icl-rocketry/iclr-hw/3d/SON127P600X800X65-8N.STEP

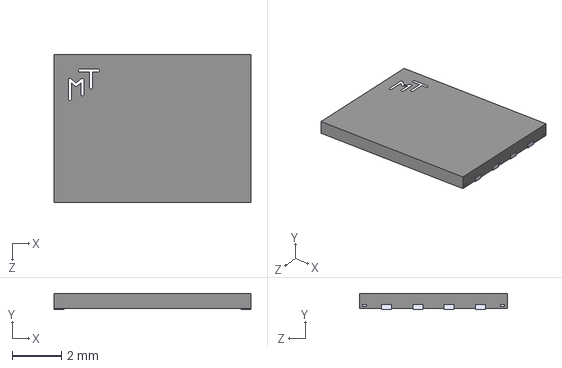
[picture p1: CAD file, 2025-12-16]
3d/SON127P600X800X65-8N.STEP
8.00 x 0.65 x 6.00 mm
