icl-rocketry/iclr-hw/3d/Pico-Clasp_SMD_4p.stp

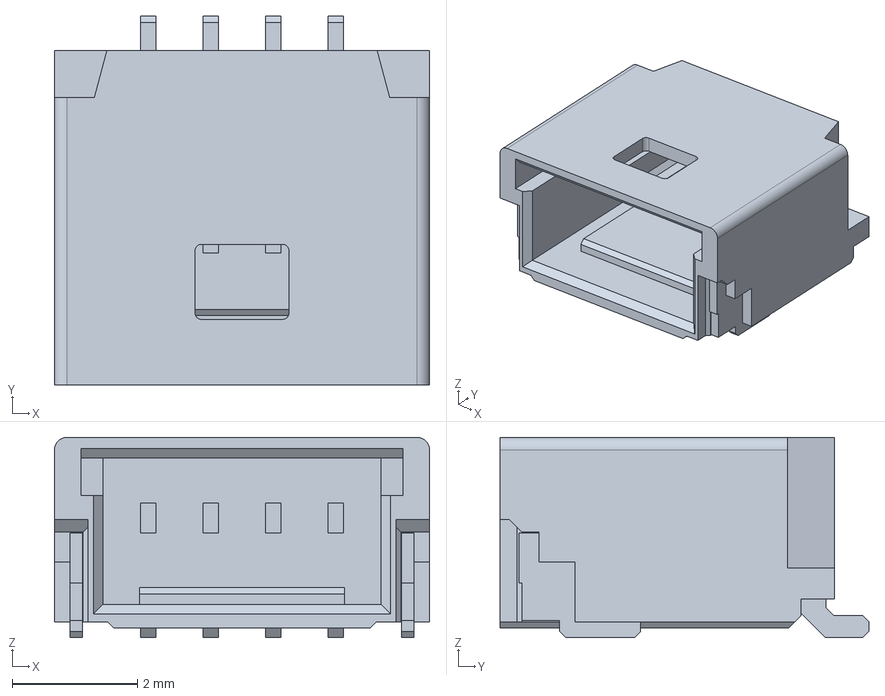
[picture p2: CAD file, 2025-05-08]
3d/Pico-Clasp_SMD_4p.stp
6.00 x 5.90 x 3.20 mm
