icl-rocketry/iclr-hw/3d/TCMT1109.STEP

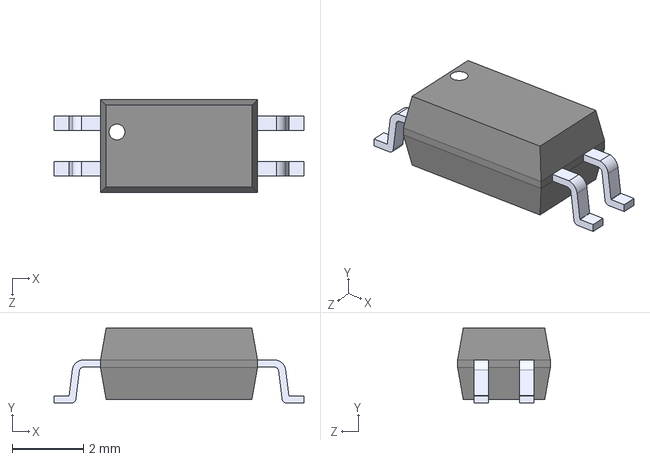
[picture p3: CAD file, 2025-05-08]
3d/TCMT1109.STEP
7.00 x 2.10 x 2.60 mm
