icl-rocketry/iclr-hw/3d/WE-XHMI.stp

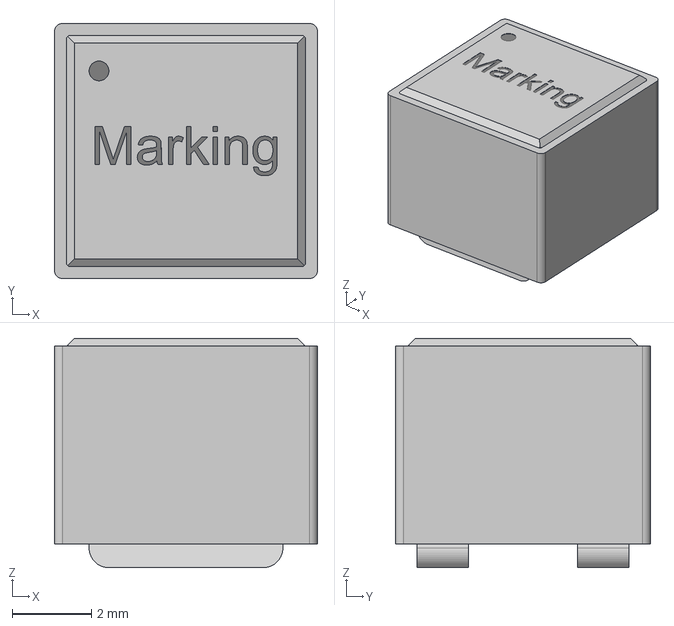
[picture p4: CAD file, 2025-05-08]
3d/WE-XHMI.stp
6.65 x 6.45 x 5.80 mm
