icl-rocketry/iclr-hw/3d/Pico-Clasp_SMD_7p.step

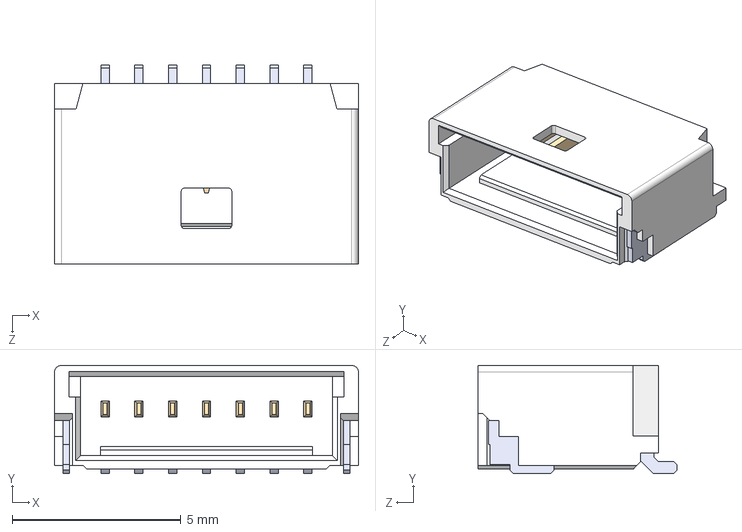
[picture p5: CAD file, 2025-02-14]
3d/Pico-Clasp_SMD_7p.step
9.00 x 3.20 x 5.90 mm
