icl-rocketry/iclr-hw/3d/2pinnanofithorizontal.STEP

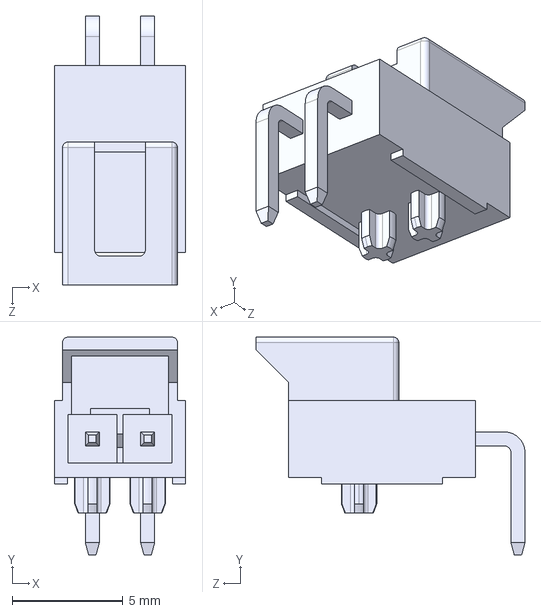
[picture p6: CAD file, 2024-09-12]
3d/2pinnanofithorizontal.STEP
5.94 x 9.84 x 12.2 mm
