icl-rocketry/iclr-hw/3d/SI7635DP-T1-GE3.STEP

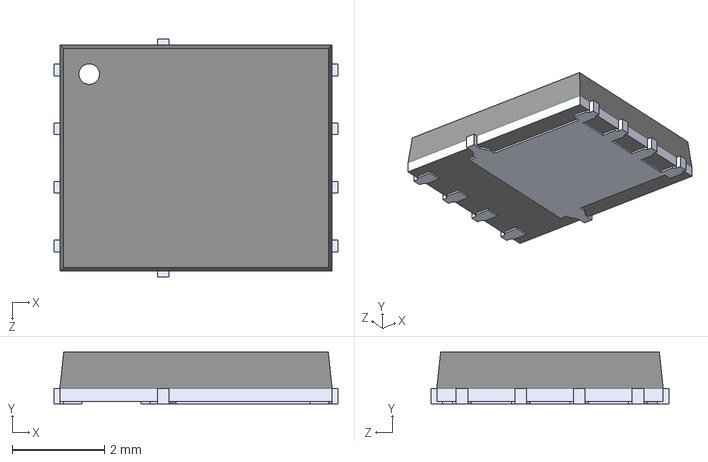
[picture p7: CAD file, 2024-09-12]
3d/SI7635DP-T1-GE3.STEP
6.15 x 1.12 x 5.16 mm
