icl-rocketry/iclr-hw/3d/FDSD0630-H-1R0M_P3.step

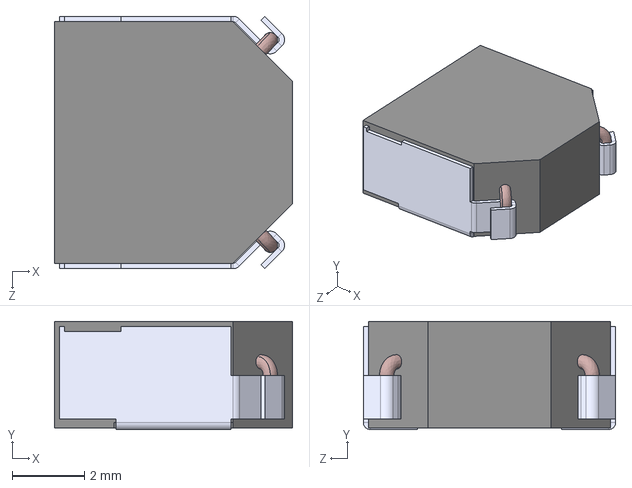
[picture p8: CAD file, 2024-09-10]
3d/FDSD0630-H-1R0M_P3.step
6.60 x 3.00 x 7.00 mm
