icl-rocketry/iclr-hw/3d/ERJ-HP6F7322V.stp

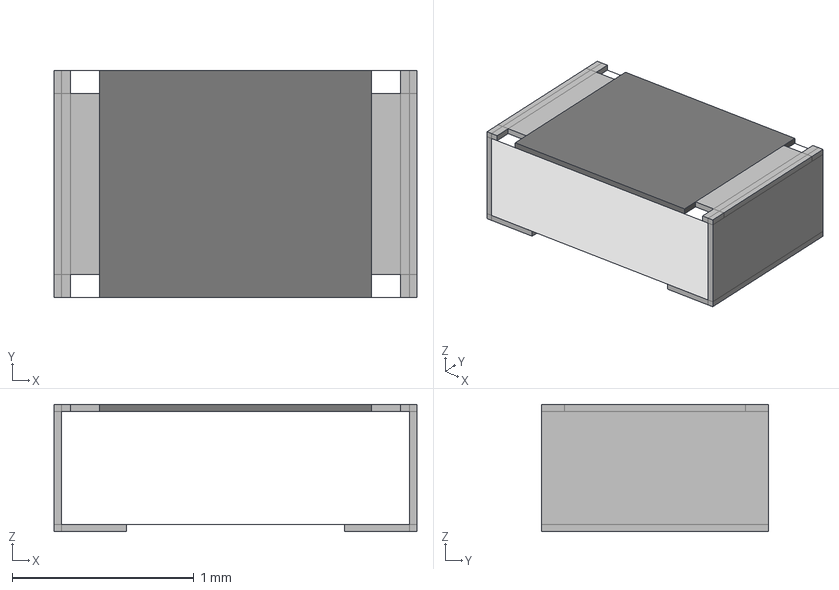
[picture p9: CAD file, 2024-09-10]
3d/ERJ-HP6F7322V.stp
2.00 x 1.25 x 0.7 mm
solidBody
solidLead
solidTop
