icl-rocketry/iclr-hw/3d/VCAS080512A250DP.stp

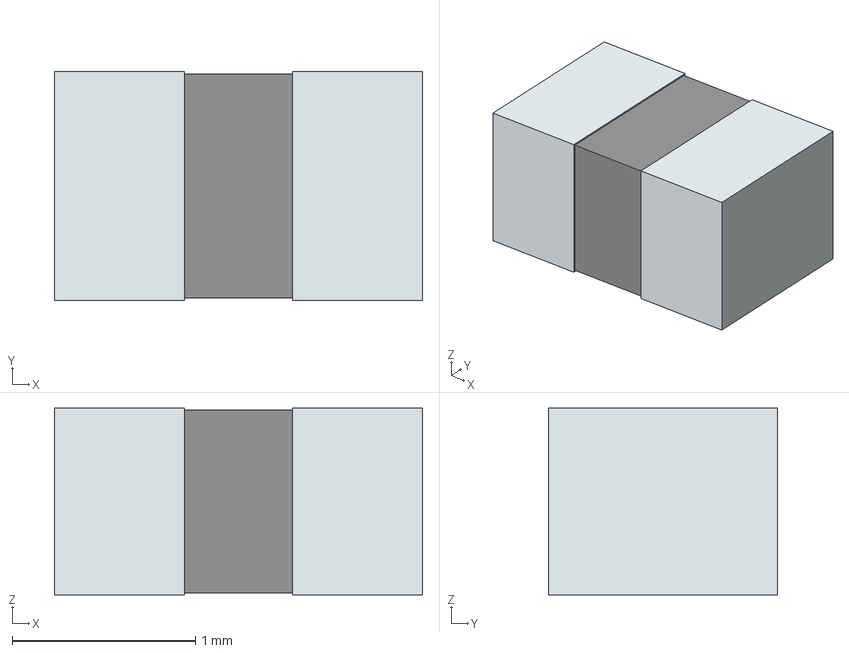
[picture p10: CAD file, 2024-09-10]
3d/VCAS080512A250DP.stp
2.01 x 1.25 x 1.02 mm
term1
term2
