icl-rocketry/iclr-hw/3d/V8PAM10S-M3_I.stp

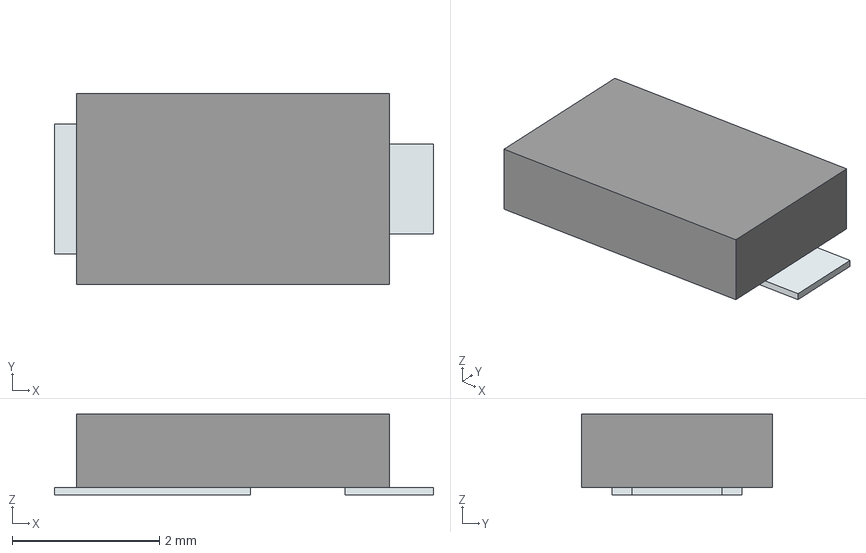
[picture p11: CAD file, 2024-09-09]
3d/V8PAM10S-M3_I.stp
5.15 x 2.60 x 1.10 mm
Pins
