icl-rocketry/iclr-hw/3d/TMC2209-LA.stp

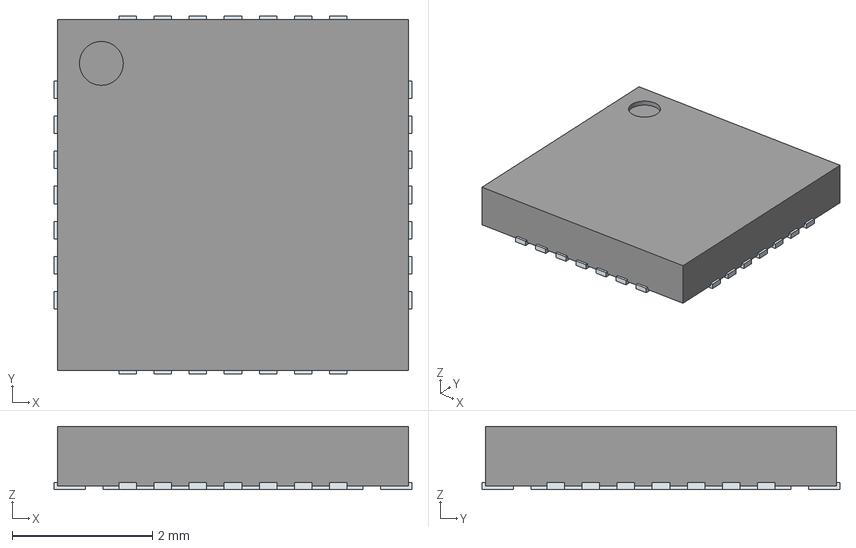
[picture p12: CAD file, 2024-08-27]
3d/TMC2209-LA.stp
5.10 x 5.10 x 0.9 mm
ThermalPin
PinsArrayLR
PinsArrayTB
