icl-rocketry/iclr-hw/3d/MIC5060YML-TR.stp

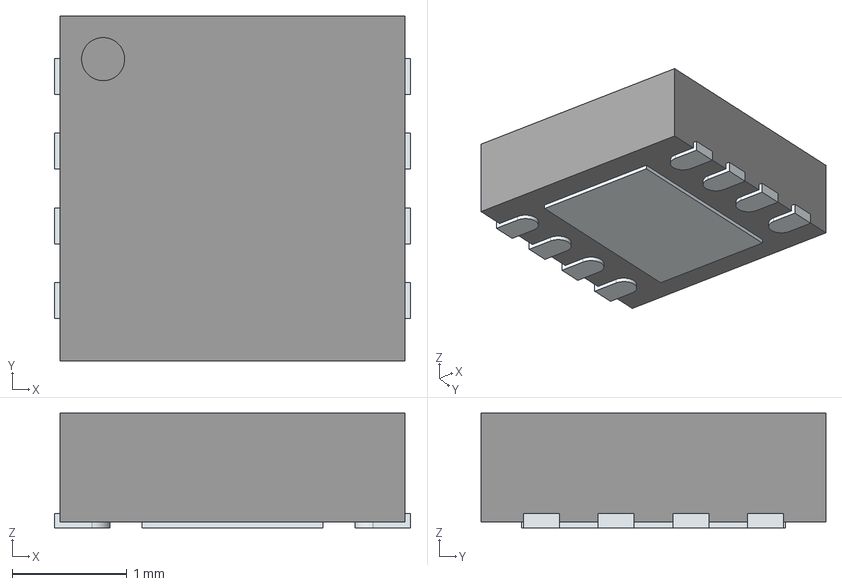
[picture p13: CAD file, 2024-08-24]
3d/MIC5060YML-TR.stp
3.10 x 3.00 x 1.00 mm
ThermalPin
PinsArrayLR
