icl-rocketry/iclr-hw/3d/BSZ025N04LS.stp

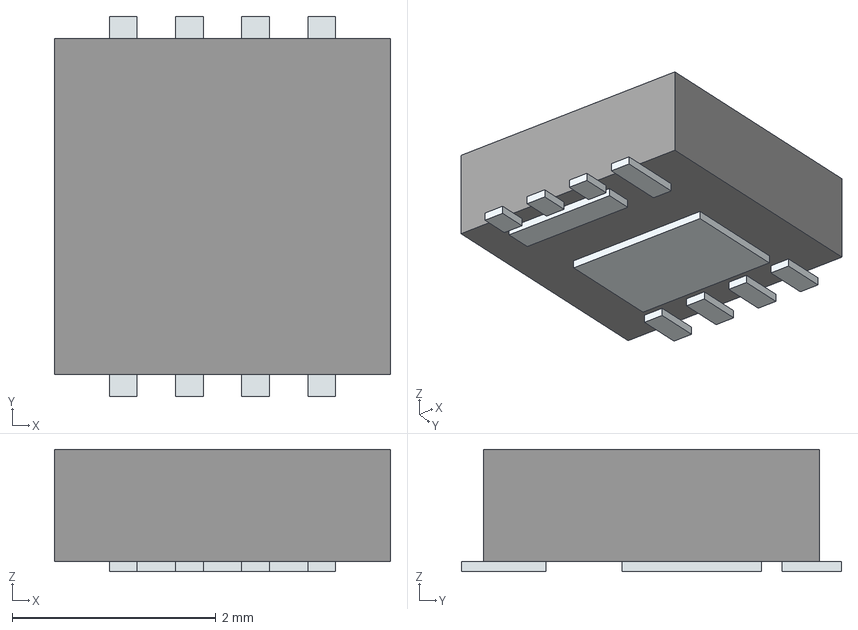
[picture p14: CAD file, 2024-08-22]
3d/BSZ025N04LS.stp
3.30 x 3.73 x 1.20 mm
Pins
