icl-rocketry/iclr-hw/3d/RCLAMP3346PTNT.stp

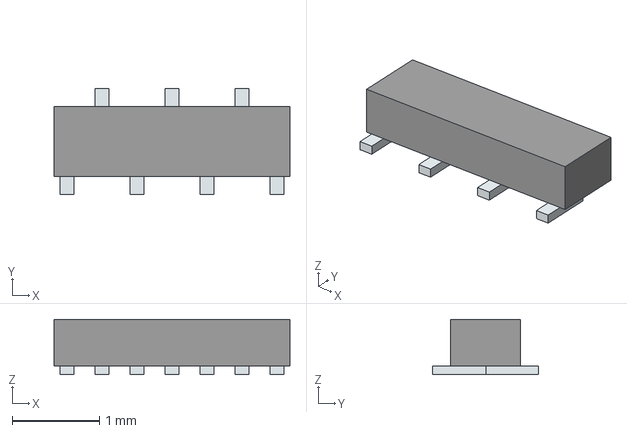
[picture p15: CAD file, 2024-08-18]
3d/RCLAMP3346PTNT.stp
2.70 x 1.21 x 0.63 mm
Pins
