icl-rocketry/iclr-hw/3d/SOT-723.step

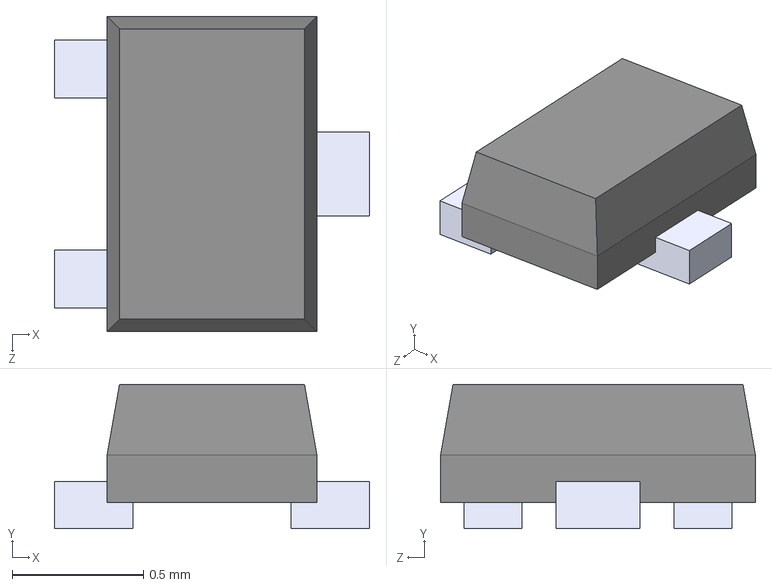
[picture p16: CAD file, 2024-08-14]
3d/SOT-723.step
1.20 x 0.55 x 1.20 mm
