icl-rocketry/iclr-hw/3d/ST1W008S4TR2000.step

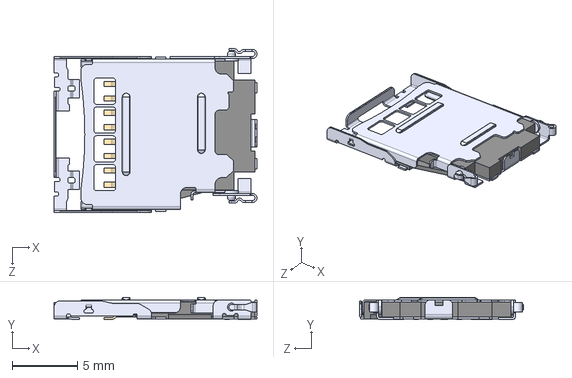
[picture p17: CAD file, 2024-08-09]
3d/ST1W008S4TR2000.step
15.5 x 1.68 x 12.5 mm
