icl-rocketry/iclr-hw/3d/CMT-0525-75-SMT-TR.stp

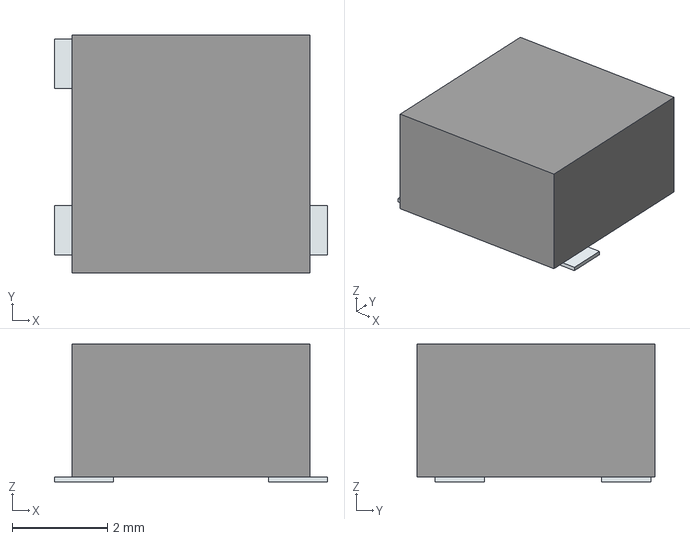
[picture p18: CAD file, 2024-08-07]
3d/CMT-0525-75-SMT-TR.stp
5.74 x 5.00 x 2.90 mm
Pins
