icl-rocketry/iclr-hw/3d/S-102T.stp

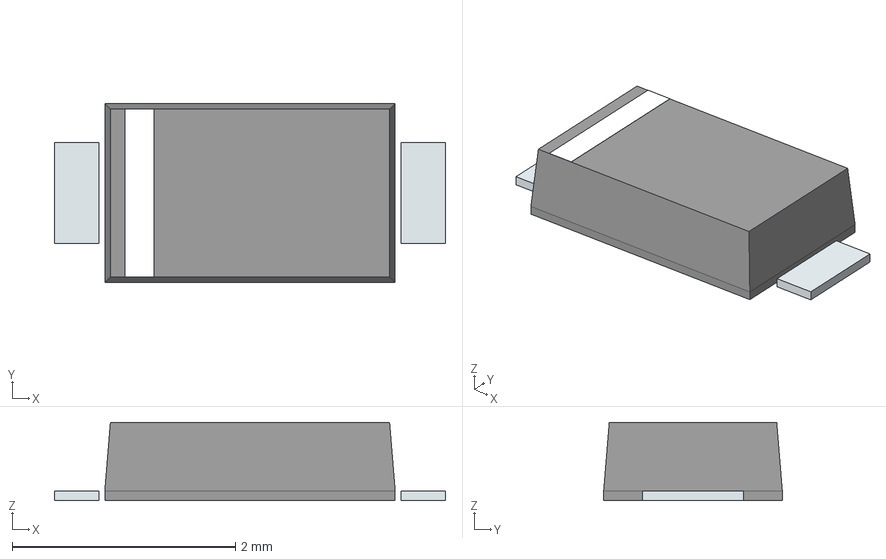
[picture p19: CAD file, 2024-08-04]
3d/S-102T.stp
3.50 x 1.60 x 0.7 mm
PinKIdent
PinK
PinA
