icl-rocketry/iclr-hw/3d/XT30PW-F.stp

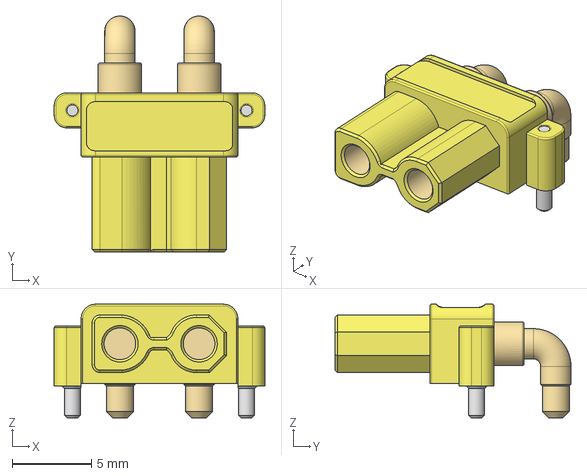
[picture p20: CAD file, 2024-07-31]
3d/XT30PW-F.stp
13.3 x 14.9 x 7.18 mm
