icl-rocketry/iclr-hw/3d/XT30PW-M.stp

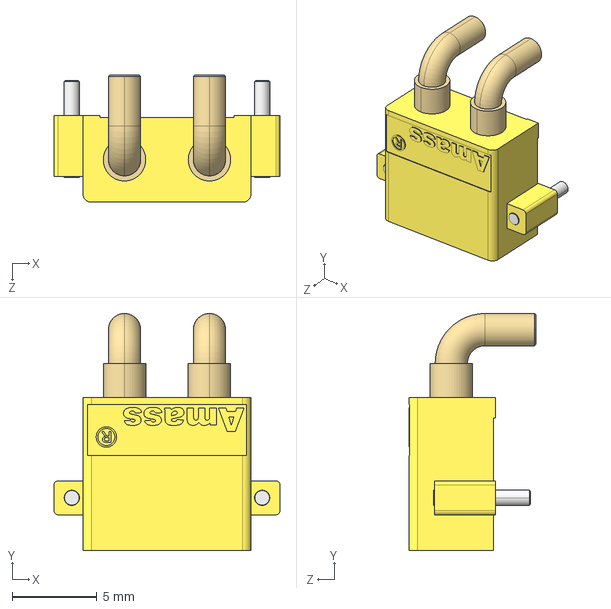
[picture p21: CAD file, 2024-07-31]
3d/XT30PW-M.stp
13.3 x 13.9 x 7.50 mm
