icl-rocketry/iclr-hw/3d/DPS368XTSA1.stp

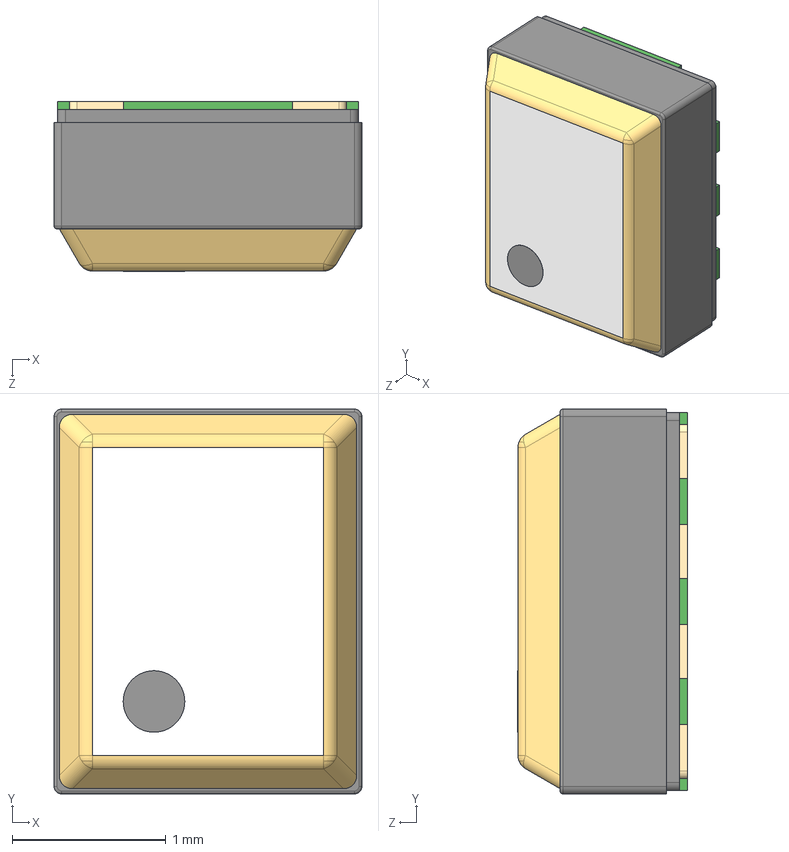
[picture p22: CAD file, 2024-07-11]
3d/DPS368XTSA1.stp
2.00 x 2.50 x 1.10 mm
Notch
Infineon Logo Adjustable_5
