icl-rocketry/iclr-hw/3d/ADS131M04IRUKR.stp

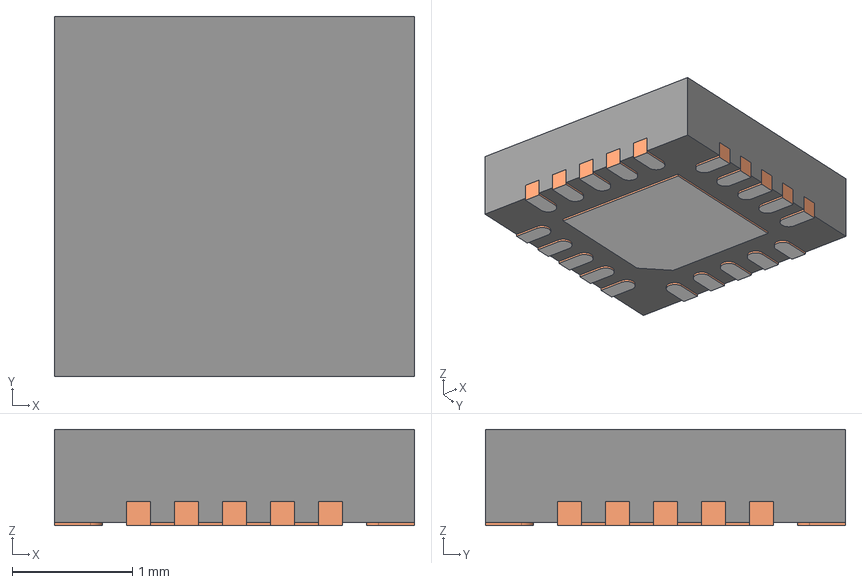
[picture p23: CAD file, 2024-06-09]
3d/ADS131M04IRUKR.stp
3.00 x 3.00 x 0.8 mm
BODY-QFN
FRAME-RUK0020B
PIN1-ID
