icl-rocketry/iclr-hw/3d/NX2016SA.STEP

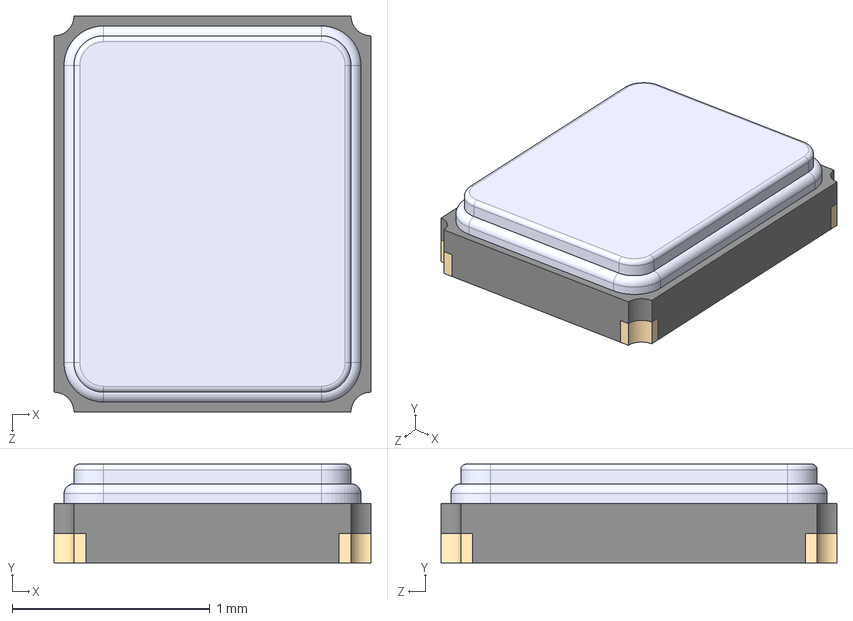
[picture p24: CAD file, 2024-06-09]
3d/NX2016SA.STEP
1.60 x 0.5 x 2.00 mm
