icl-rocketry/iclr-hw/3d/SQS141ELNW-T1_GE3.stp

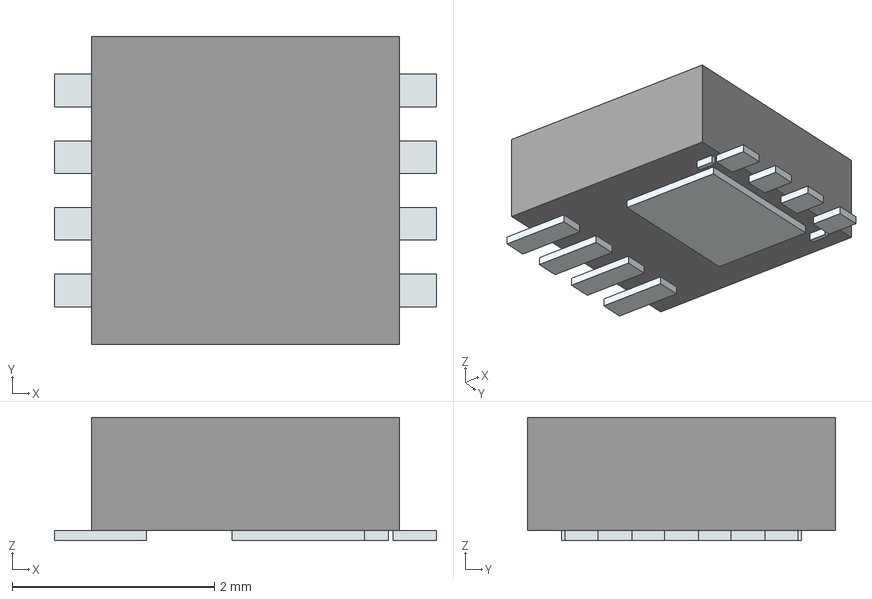
[picture p25: CAD file, 2024-06-09]
3d/SQS141ELNW-T1_GE3.stp
3.78 x 3.05 x 1.22 mm
Pins
