icl-rocketry/iclr-hw/3d/SER2011.STEP

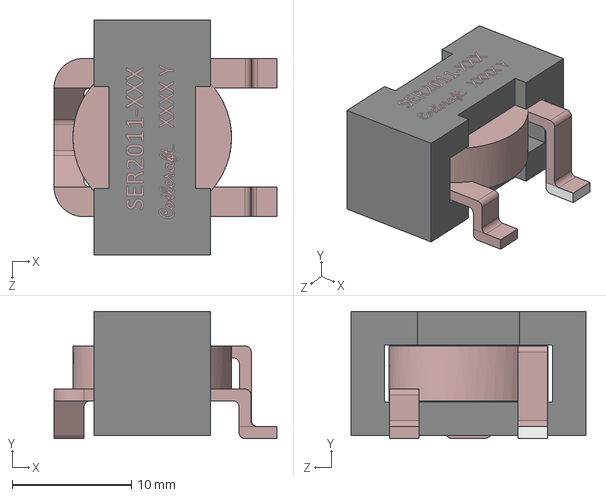
[picture p26: CAD file, 2024-06-09]
3d/SER2011.STEP
18.7 x 10.7 x 19.7 mm
