icl-rocketry/iclr-hw/3d/SRP1050WA-3R3M v0.step

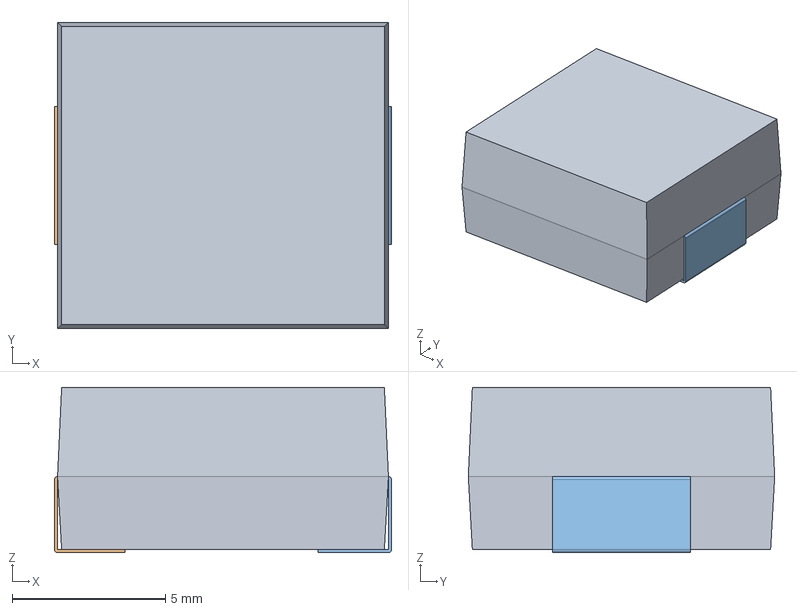
[picture p27: CAD file, 2024-06-09]
3d/SRP1050WA-3R3M v0.step
11.0 x 10.0 x 5.40 mm
FilletPin1
FilletPin2
