icl-rocketry/iclr-hw/3d/23Buckaroo v4.step

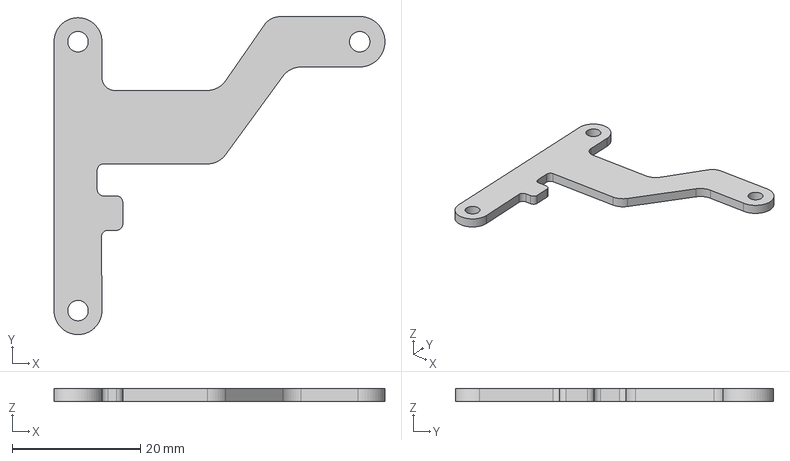
[picture p28: CAD file, 2024-06-09]
3d/23Buckaroo v4.step
51.7 x 49.7 x 2.00 mm
