icl-rocketry/iclr-hw/3d/BUK9M11-40HX.stp

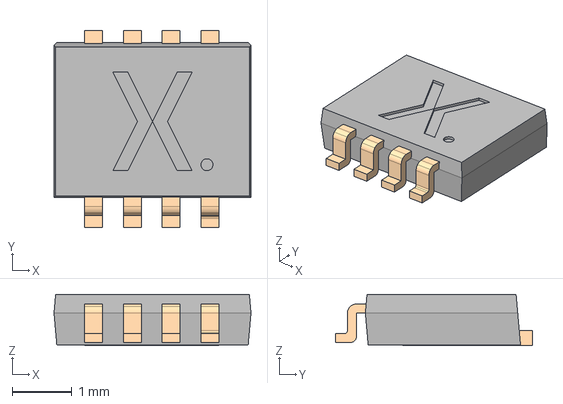
[picture p29: CAD file, 2024-06-09]
3d/BUK9M11-40HX.stp
3.30 x 3.30 x 0.855 mm
