icl-rocketry/iclr-hw/3d/WLPMA0A040M2R2LC.step

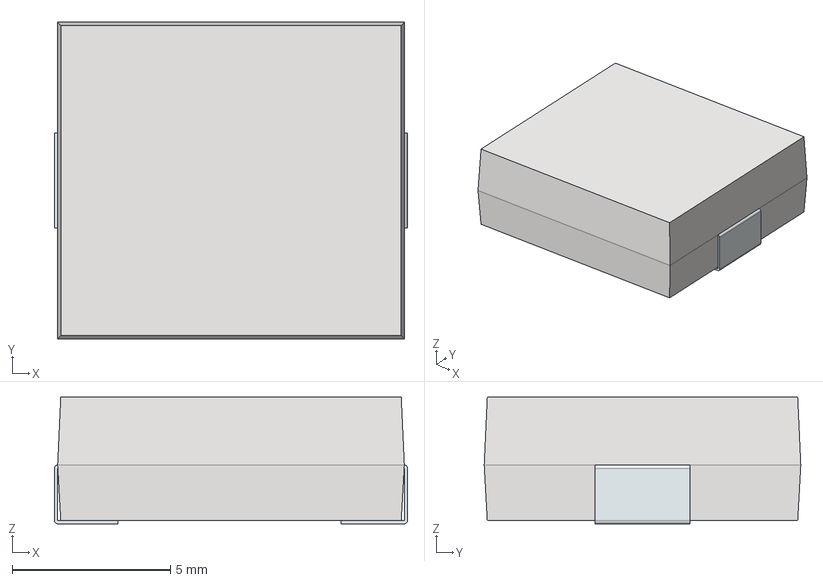
[picture p30: CAD file, 2024-06-09]
3d/WLPMA0A040M2R2LC.step
11.2 x 10.0 x 4.00 mm
FilletPin1
FilletPin2
