icl-rocketry/iclr-hw/3d/XT30PW MALE.STEP

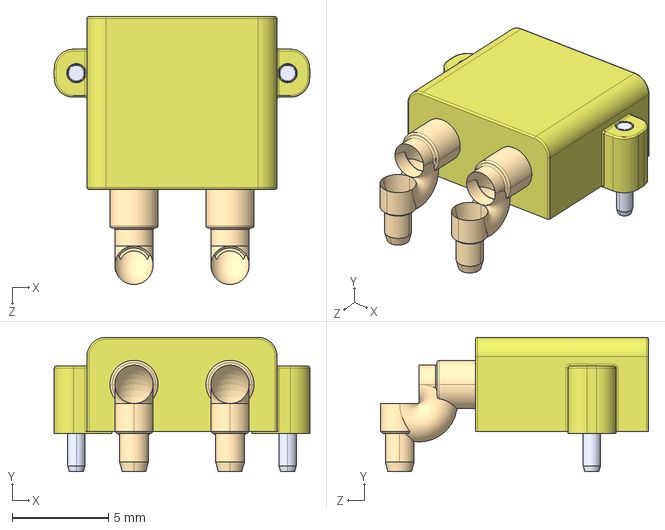
[picture p31: CAD file, 2024-06-09]
3d/XT30PW MALE.STEP
13.3 x 7.00 x 14.0 mm
