icl-rocketry/iclr-hw/3d/XTSD08GLGEAG.stp

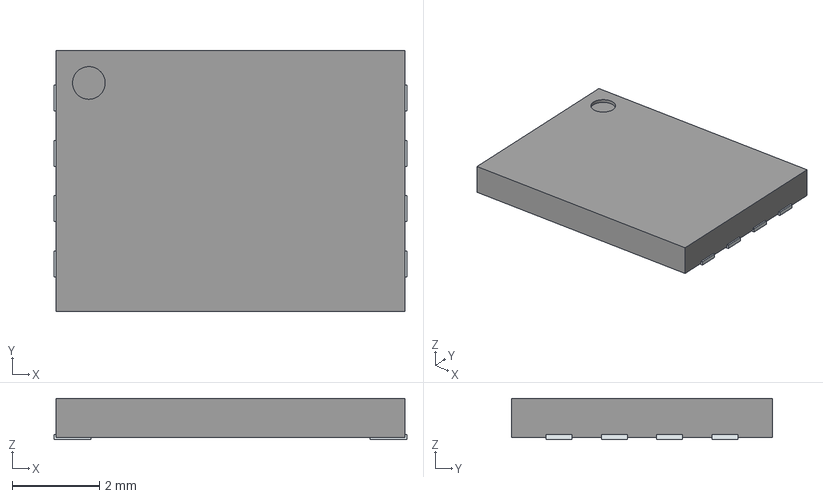
[picture p32: CAD file, 2024-06-09]
3d/XTSD08GLGEAG.stp
8.10 x 6.00 x 0.95 mm
PinsArrayLR
