icl-rocketry/iclr-hw/3d/MPRLS0025PA00001A.stp

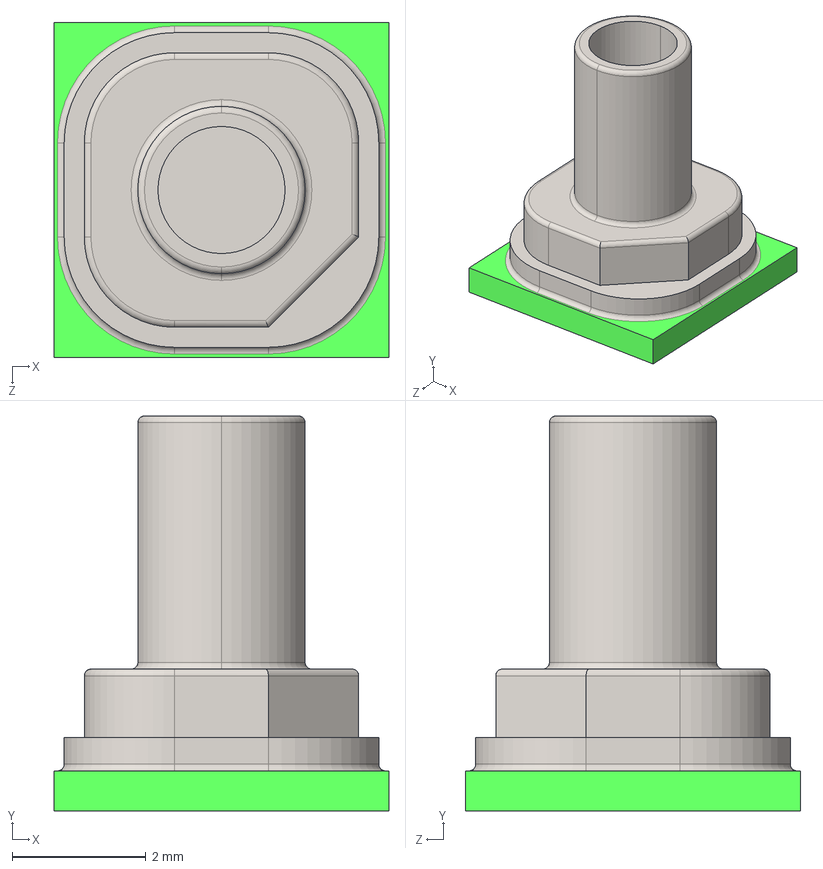
[picture p33: CAD file, 2024-06-09]
3d/MPRLS0025PA00001A.stp
5.00 x 5.90 x 5.00 mm
