icl-rocketry/iclr-hw/3d/B540C-13-F.step

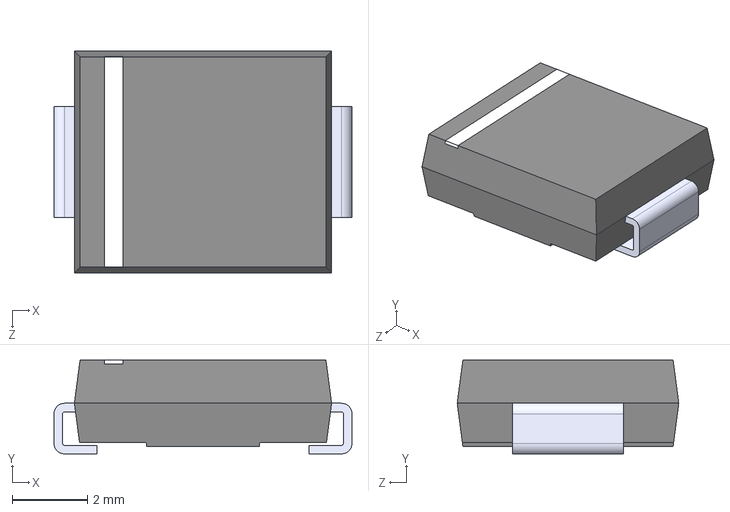
[picture p34: CAD file, 2024-03-06]
3d/B540C-13-F.step
7.94 x 2.50 x 5.91 mm
