icl-rocketry/iclr-hw/3d/P0848NL.stp

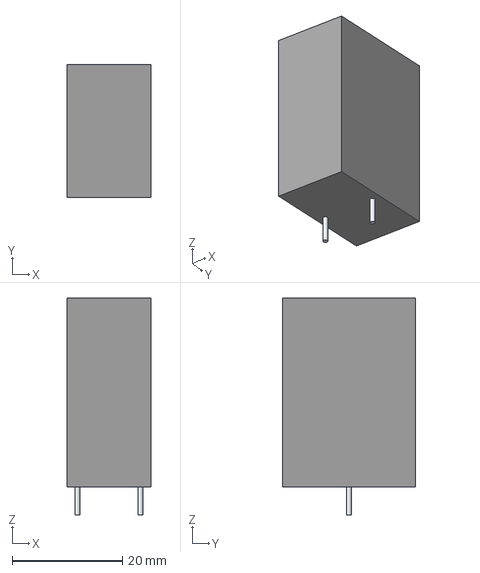
[picture p35: CAD file, 2024-03-06]
3d/P0848NL.stp
15.2 x 24.1 x 39.4 mm
Leads x 2
