icl-rocketry/iclr-hw/3d/SBR1045CTL-13.step

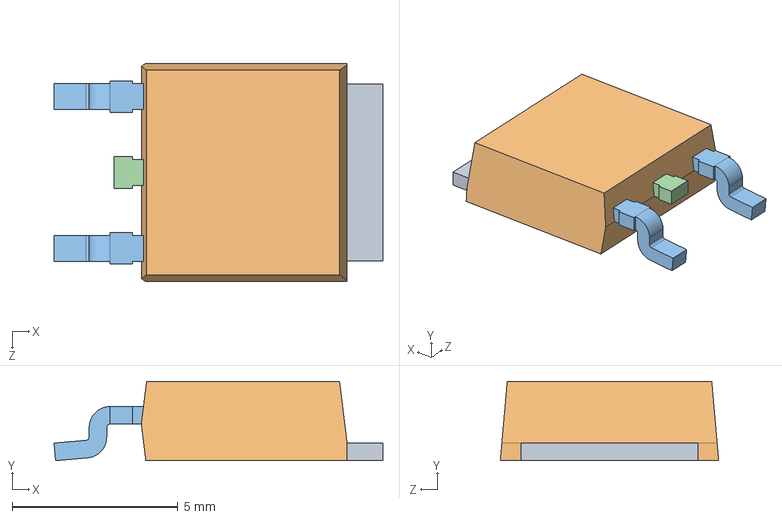
[picture p36: CAD file, 2024-03-06]
3d/SBR1045CTL-13.step
9.91 x 2.39 x 6.58 mm
