icl-rocketry/iclr-hw/3d/MIC2253-06YML.stp

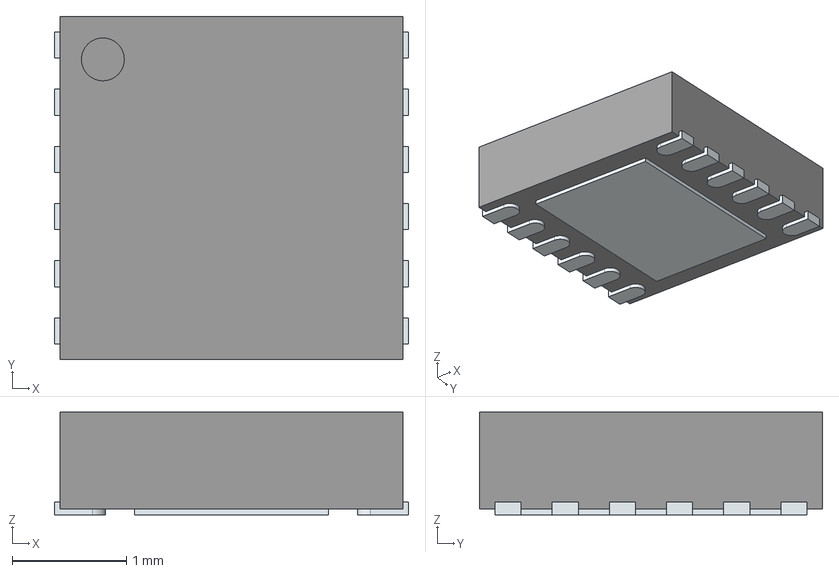
[picture p37: CAD file, 2024-01-30]
3d/MIC2253-06YML.stp
3.10 x 3.00 x 0.9 mm
ThermalPin
PinsArrayLR
