icl-rocketry/iclr-hw/3d/ADS131M06IRSNR.stp

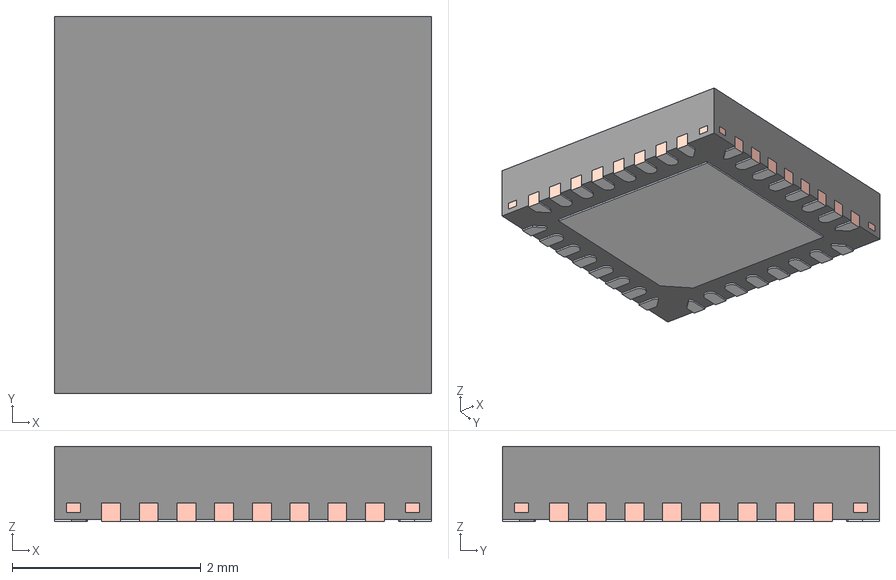
[picture p38: CAD file, 2023-08-23]
3d/ADS131M06IRSNR.stp
4.00 x 4.00 x 0.8 mm
BODY-QFN
FRAME-RSN0032B
PIN1-ID
