icl-rocketry/iclr-hw/3d/2pinTerminal2.54.stp

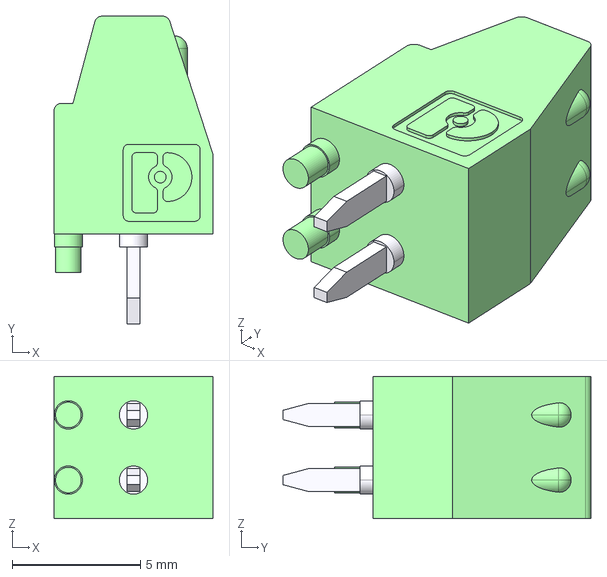
[picture p39: CAD file, 2023-08-23]
3d/2pinTerminal2.54.stp
6.20 x 12.0 x 5.54 mm
