icl-rocketry/iclr-hw/3d/2pinTerminal3.5.STEP

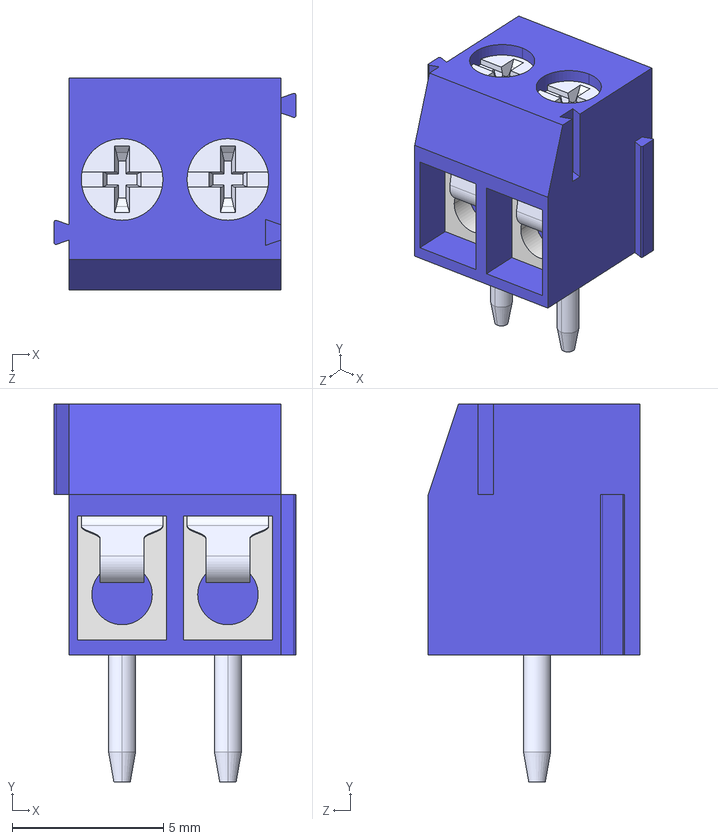
[picture p40: CAD file, 2023-08-23]
3d/2pinTerminal3.5.STEP
8.00 x 12.5 x 7.00 mm
