icl-rocketry/iclr-hw/3d/SRR6038-5R0Y.stp

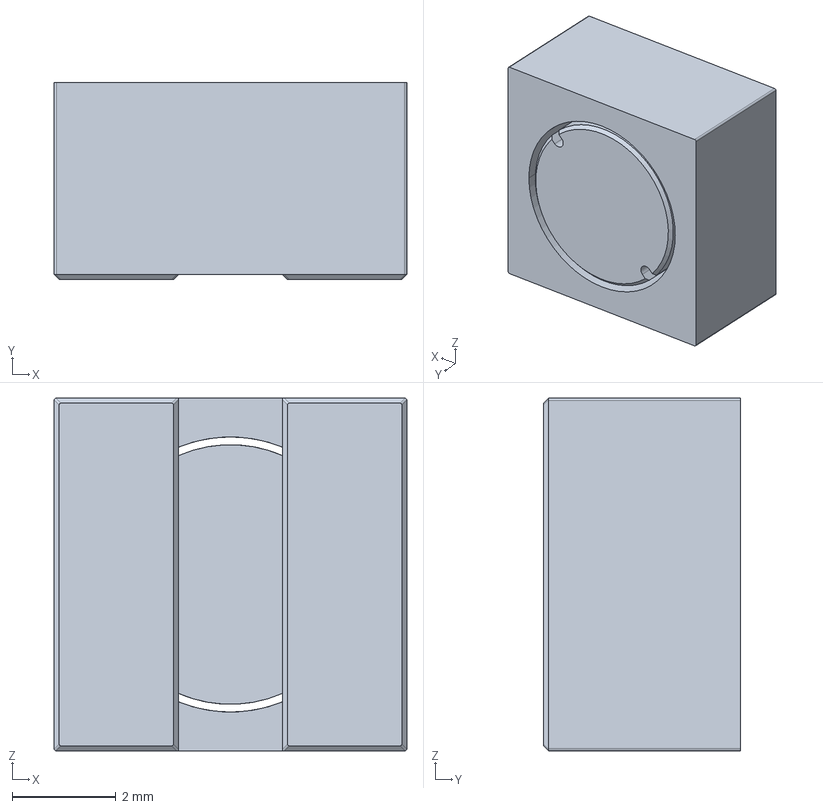
[picture p41: CAD file, 2023-08-23]
3d/SRR6038-5R0Y.stp
6.80 x 3.80 x 6.80 mm
