icl-rocketry/iclr-hw/3d/4pinnanofithorizontal.stp

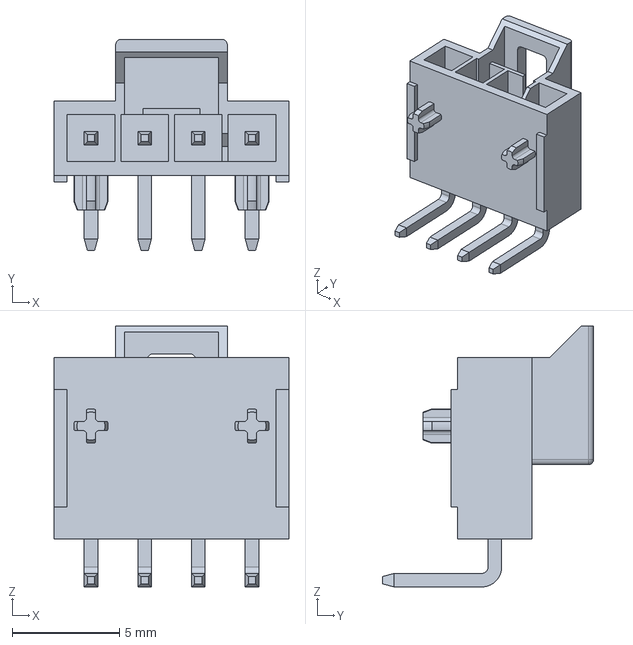
[picture p42: CAD file, 2023-08-23]
3d/4pinnanofithorizontal.stp
10.9 x 9.84 x 12.2 mm
