icl-rocketry/iclr-hw/3d/HEF4051BT,653.STEP

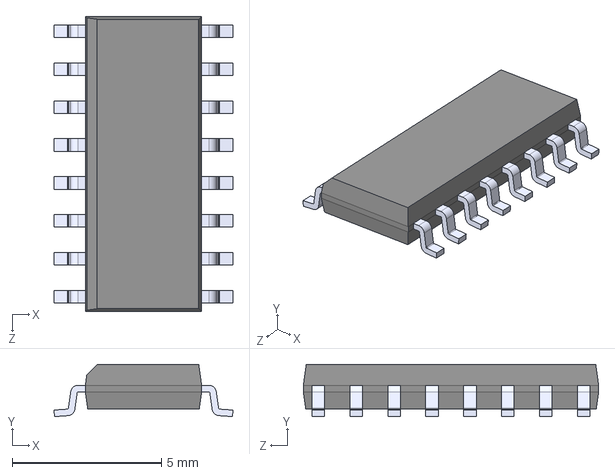
[picture p43: CAD file, 2023-07-05]
3d/HEF4051BT,653.STEP
6.00 x 1.75 x 9.90 mm
