icl-rocketry/iclr-hw/3d/MAX-M8Q.STEP

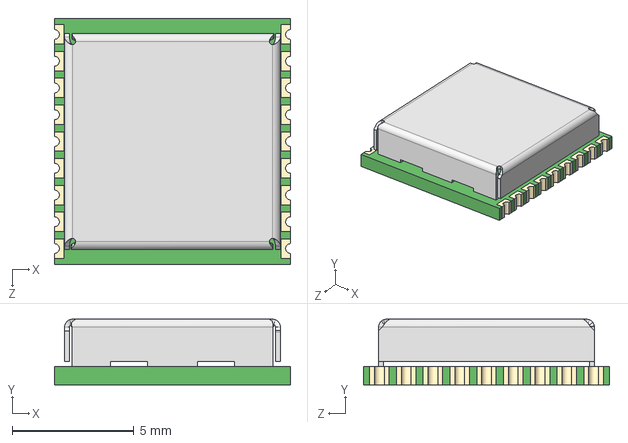
[picture p44: CAD file, 2023-06-16]
3d/MAX-M8Q.STEP
9.70 x 2.70 x 10.1 mm
