icl-rocketry/iclr-hw/3d/RBus0204Hor.stp

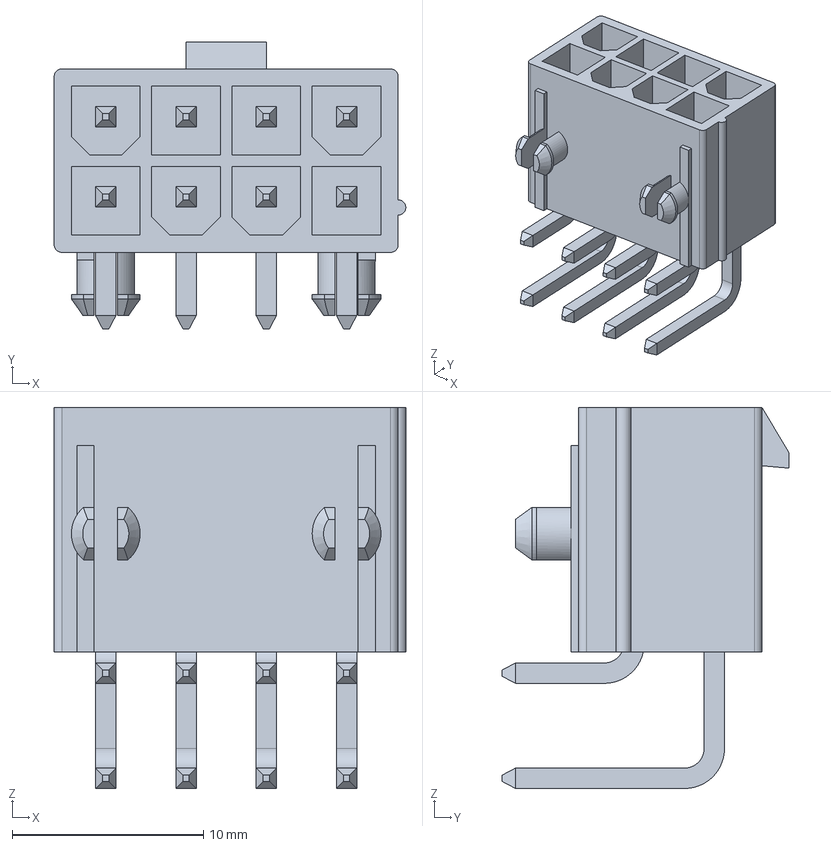
[picture p45: CAD file, 2023-06-16]
3d/RBus0204Hor.stp
18.4 x 15.0 x 19.9 mm
