icl-rocketry/iclr-hw/3d/MMC5983MA.STEP

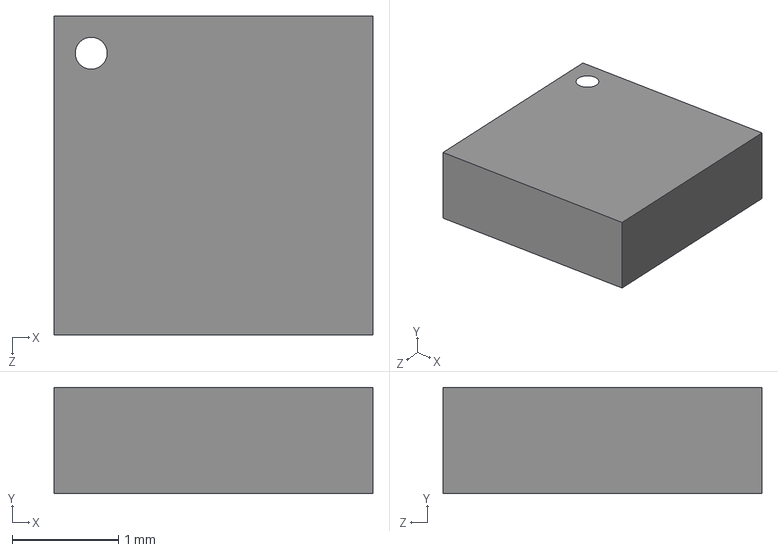
[picture p46: CAD file, 2023-06-16]
3d/MMC5983MA.STEP
3.00 x 1.00 x 3.00 mm
