icl-rocketry/iclr-hw/3d/ESP32-S3.STEP

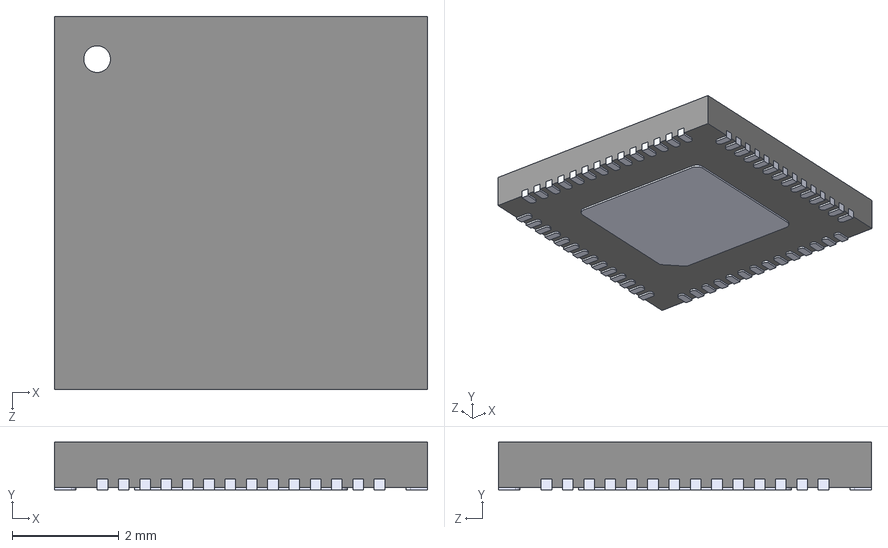
[picture p47: CAD file, 2023-06-16]
3d/ESP32-S3.STEP
7.00 x 0.9 x 7.00 mm
