icl-rocketry/iclr-hw/3d/SOIC-8.STEP

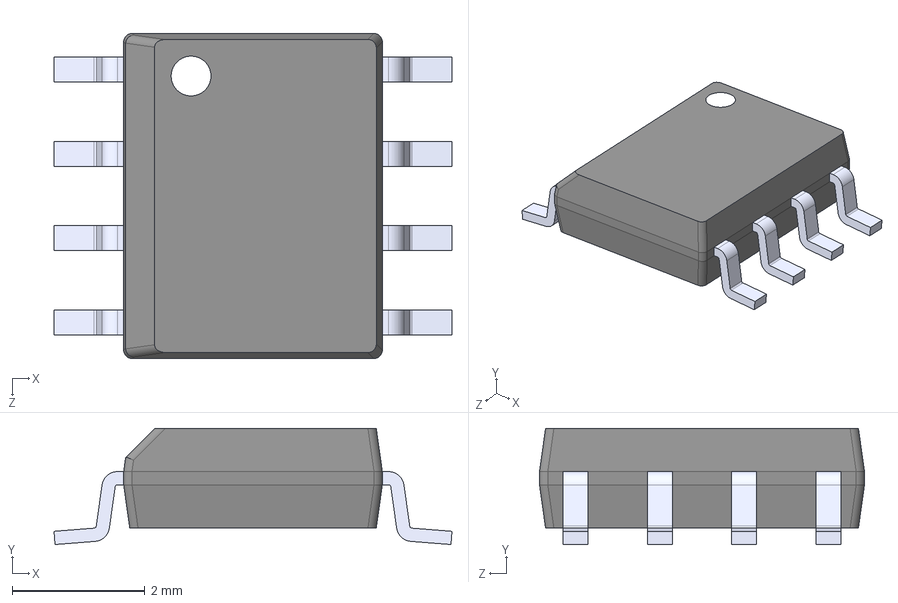
[picture p48: CAD file, 2023-06-16]
3d/SOIC-8.STEP
6.00 x 1.75 x 4.90 mm
