icl-rocketry/iclr-hw/3d/ETQP4M4R7KVC.STEP

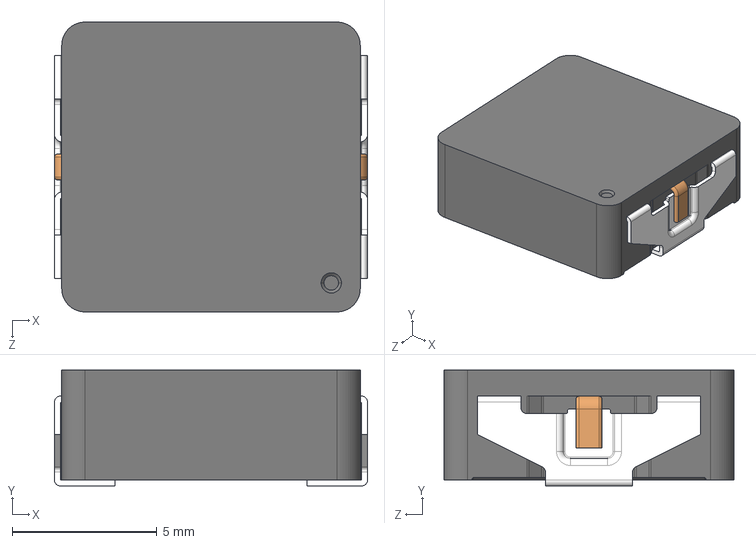
[picture p49: CAD file, 2023-06-16]
3d/ETQP4M4R7KVC.STEP
10.8 x 4.00 x 10.0 mm
