icl-rocketry/iclr-hw/3d/PXP012-30QLJ.stp

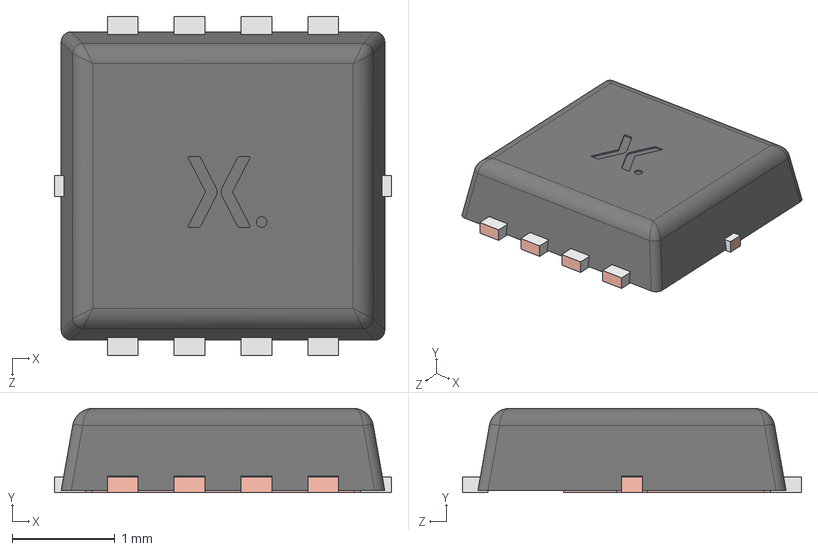
[picture p50: CAD file, 2023-06-16]
3d/PXP012-30QLJ.stp
3.28 x 0.82 x 3.30 mm
SOT8002 Stamped LF
SOT8002 body
