icl-rocketry/iclr-hw/3d/SN74LVC2G132DCUR.stp

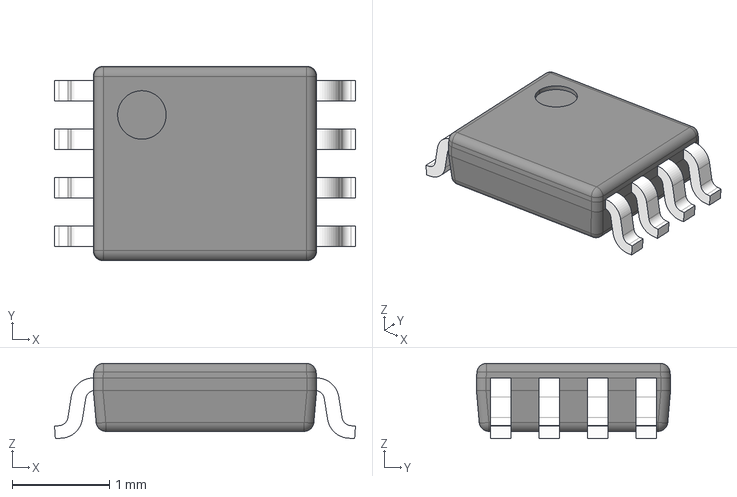
[picture p51: CAD file, 2023-06-16]
3d/SN74LVC2G132DCUR.stp
3.10 x 2.00 x 0.775 mm
BODY-VSSOP
LEAD-VSSOP x 8
