icl-rocketry/iclr-hw/3d/SMAConnector.step

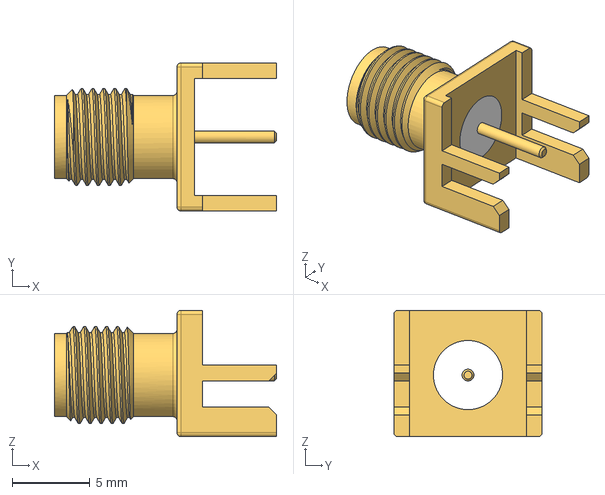
[picture p52: CAD file, 2023-06-16]
3d/SMAConnector.step
14.3 x 9.53 x 8.12 mm
