icl-rocketry/iclr-hw/3d/MPL-AL6050-4R7.STEP

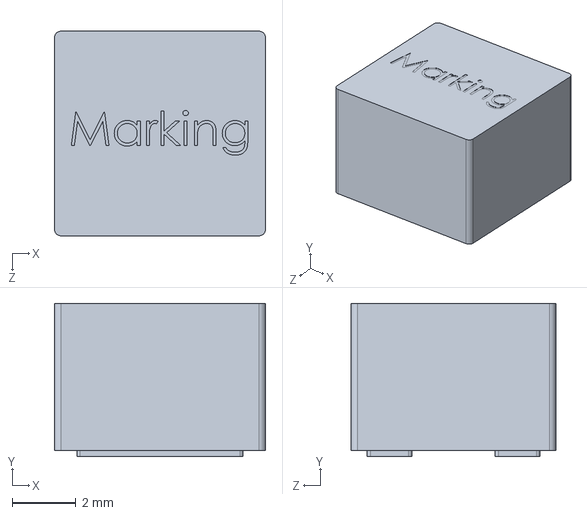
[picture p54: CAD file, 2023-06-16]
3d/MPL-AL6050-4R7.STEP
6.60 x 4.80 x 6.40 mm
