icl-rocketry/iclr-hw/3d/H3LIS331DLTR.stp

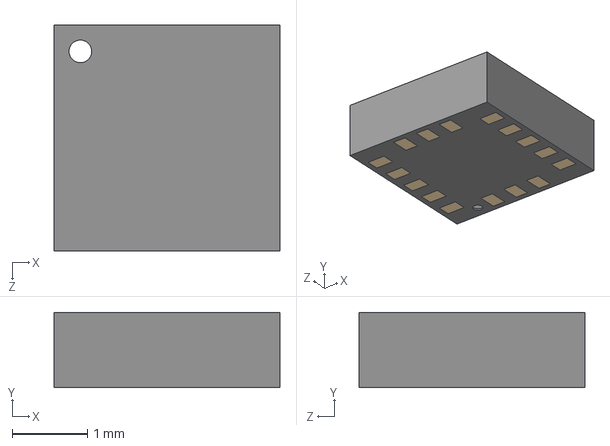
[picture p55: CAD file, 2023-06-16]
3d/H3LIS331DLTR.stp
3.00 x 1.00 x 3.00 mm
