icl-rocketry/iclr-hw/3d/AP2205-W5-7.stp

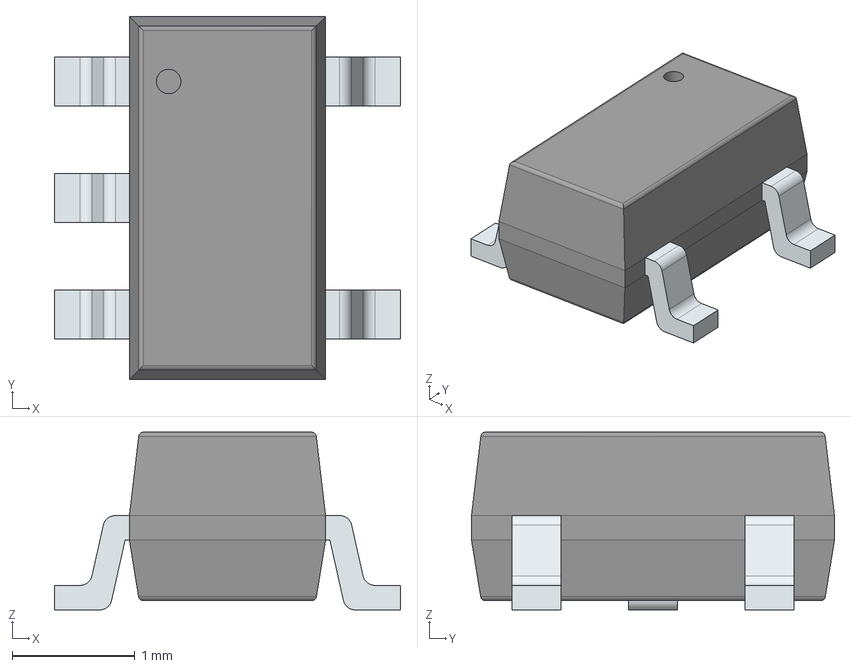
[picture p56: CAD file, 2023-06-16]
3d/AP2205-W5-7.stp
2.83 x 2.96 x 1.45 mm
PinsArrayL
PinsArrayR
