icl-rocketry/iclr-hw/3d/SN74LVC2G04DBVR.stp

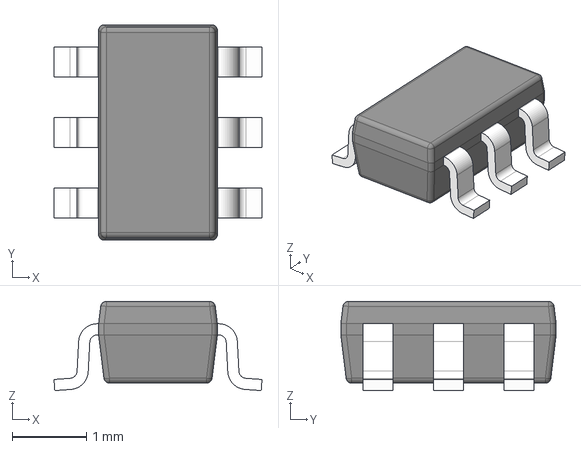
[picture p57: CAD file, 2023-06-16]
3d/SN74LVC2G04DBVR.stp
2.80 x 2.90 x 1.20 mm
BODY-SOT
LEAD-SOT x 6
