icl-rocketry/iclr-hw/3d/SN74LV32ADGVR.stp

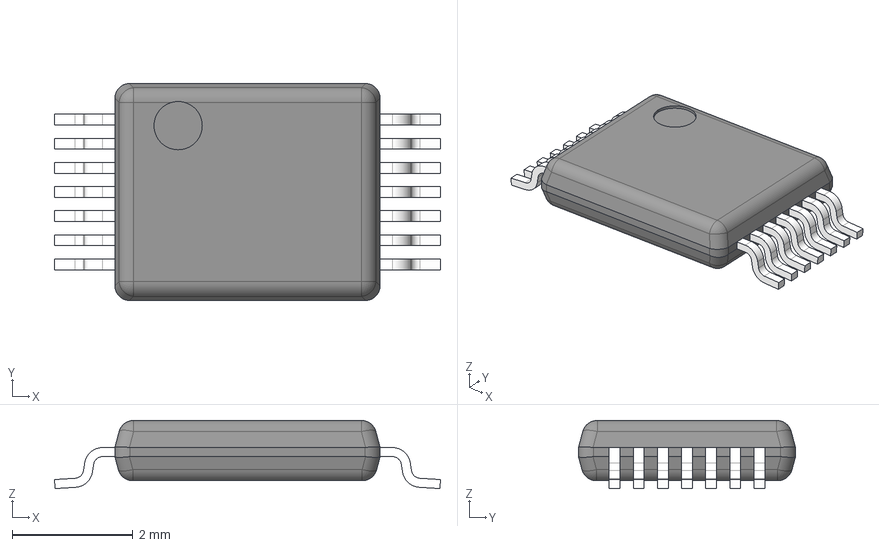
[picture p58: CAD file, 2023-06-16]
3d/SN74LV32ADGVR.stp
6.40 x 3.60 x 1.13 mm
BODY-TVSOP
LEAD-TVSOP x 14
PIN1
