icl-rocketry/iclr-hw/3d/RBus0203Hor.stp

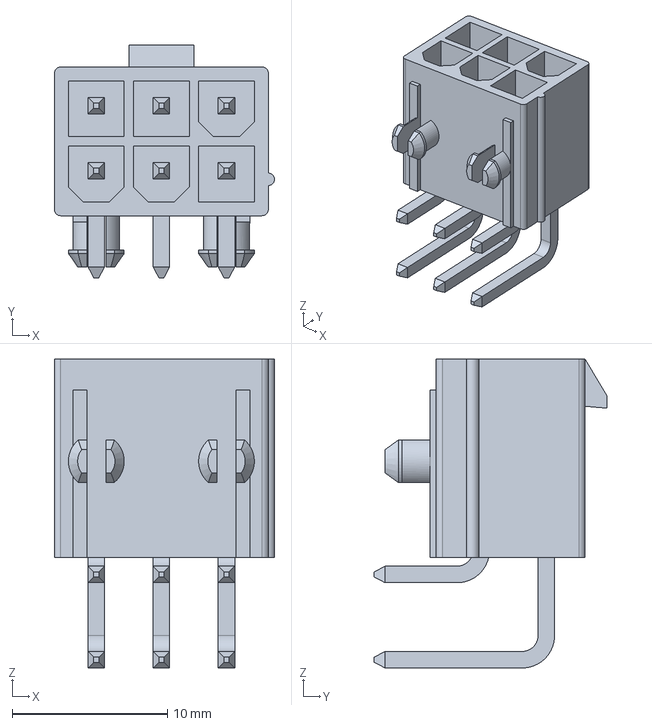
[picture p59: CAD file, 2023-02-27]
3d/RBus0203Hor.stp
14.2 x 15.0 x 19.9 mm
