icl-rocketry/iclr-hw/3d/XT60PW MALE.STEP

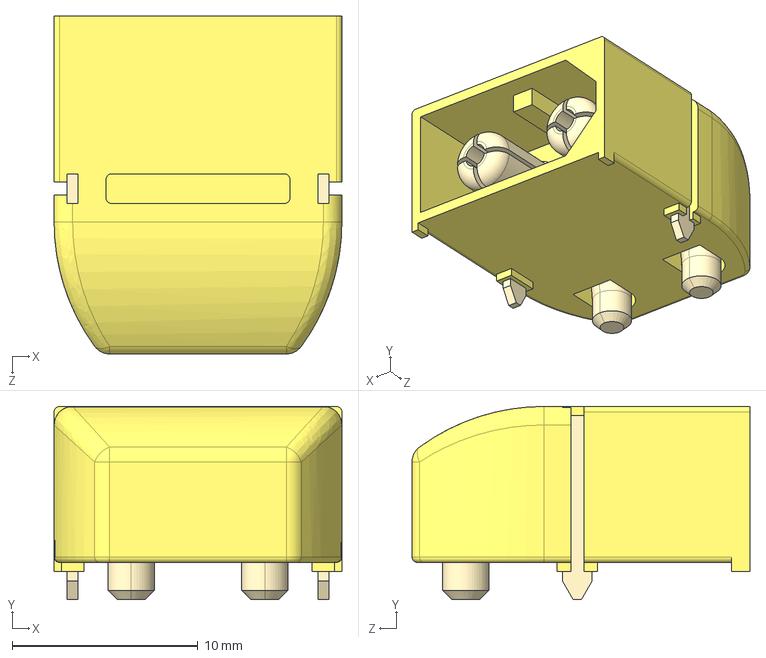
[picture p60: CAD file, 2023-02-27]
3d/XT60PW MALE.STEP
15.5 x 10.4 x 18.2 mm
