icl-rocketry/iclr-hw/3d/USB_C.step

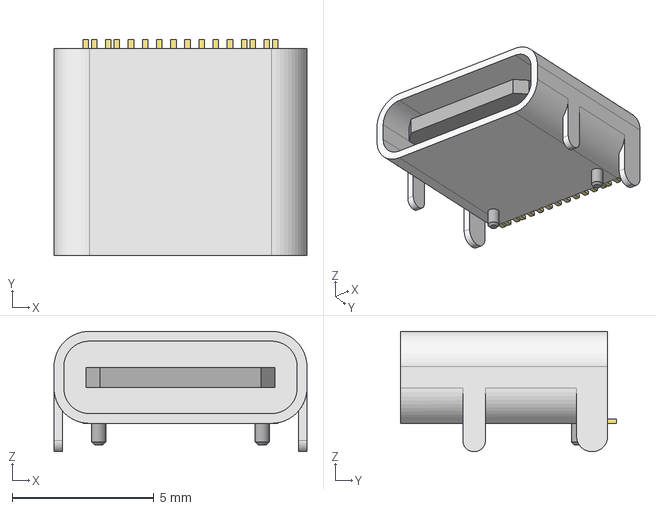
[picture p61: CAD file, 2023-02-27]
3d/USB_C.step
8.94 x 7.63 x 4.25 mm
