icl-rocketry/iclr-hw/3d/3pinnanofithorizontal.stp

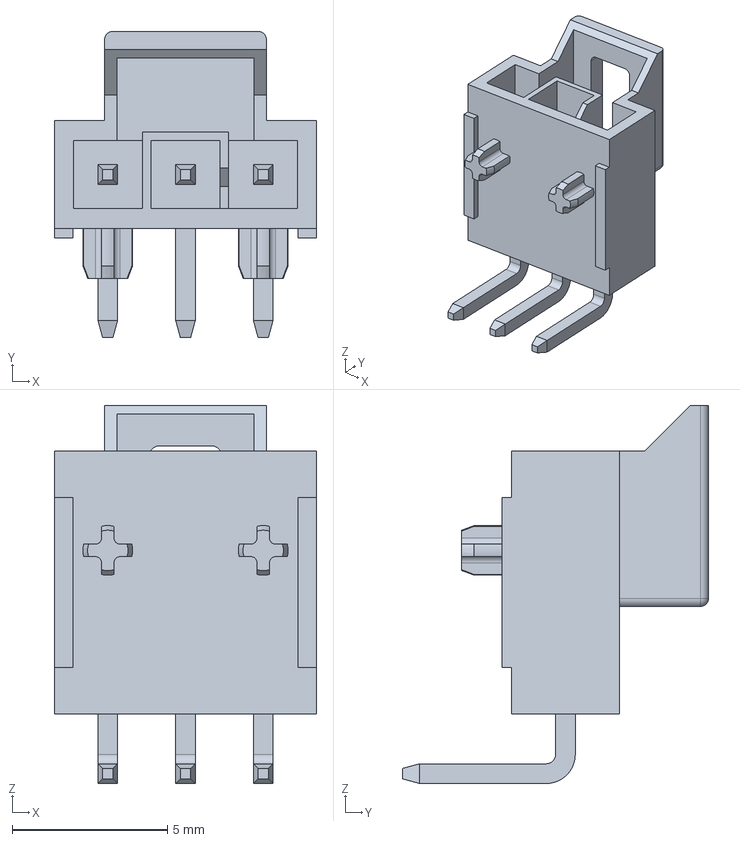
[picture p62: CAD file, 2023-02-27]
3d/3pinnanofithorizontal.stp
8.44 x 9.84 x 12.2 mm
