icl-rocketry/iclr-hw/3d/XT60PW FEMALE.STEP

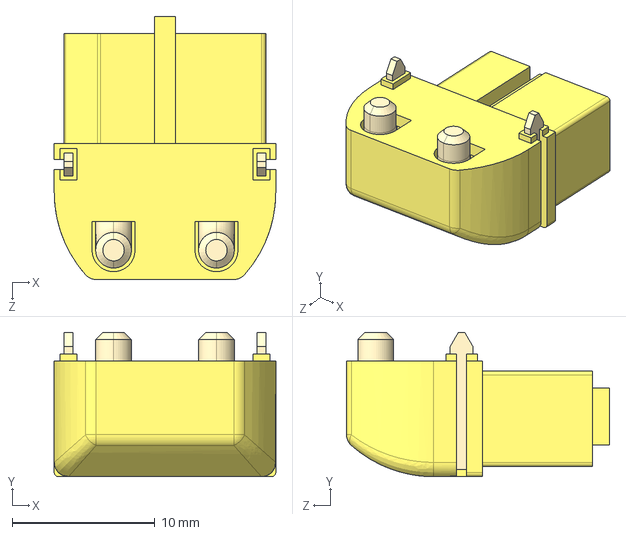
[picture p63: CAD file, 2023-02-27]
3d/XT60PW FEMALE.STEP
15.5 x 10.1 x 18.4 mm
