icl-rocketry/iclr-hw/3d/EXL1V0705-3R3-R.stp

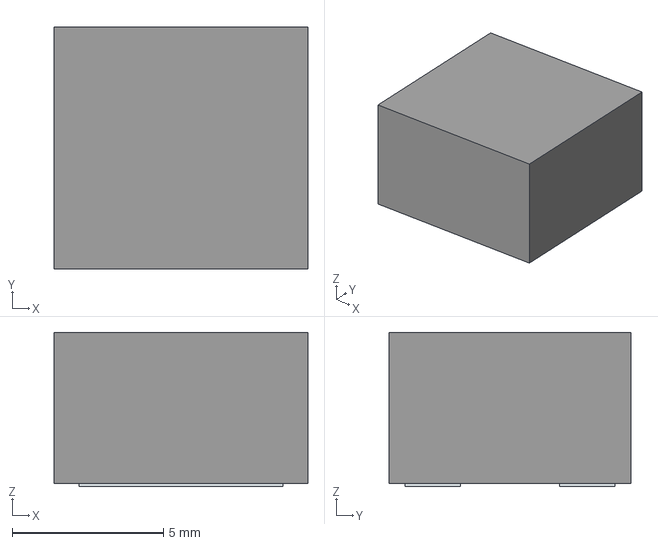
[picture p64: CAD file, 2023-02-27]
3d/EXL1V0705-3R3-R.stp
8.40 x 8.00 x 5.10 mm
Pins
