icl-rocketry/iclr-hw/3d/USB4110-GF-A_REVB.step

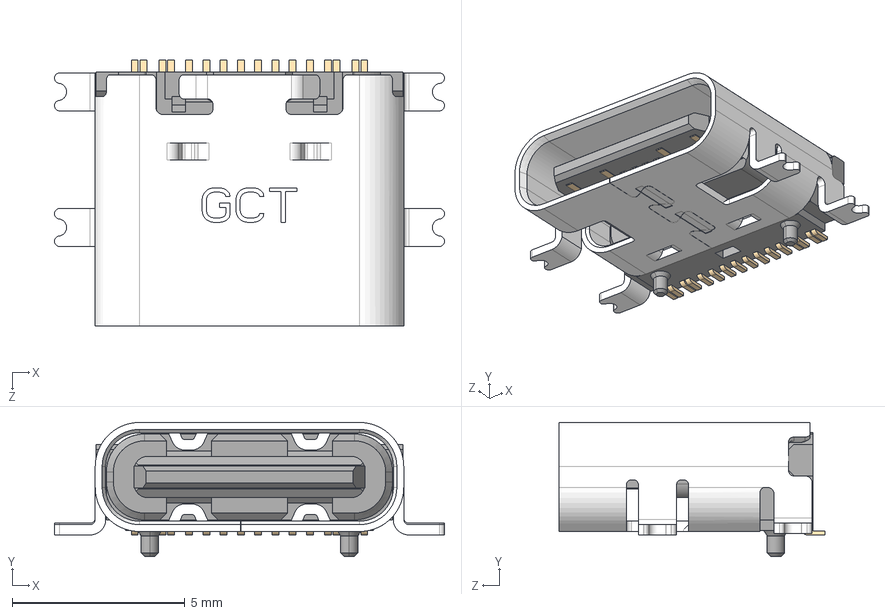
[picture p65: CAD file, 2023-02-04]
3d/USB4110-GF-A_REVB.step
11.3 x 3.89 x 7.70 mm
