icl-rocketry/iclr-hw/3d/DPS310.step

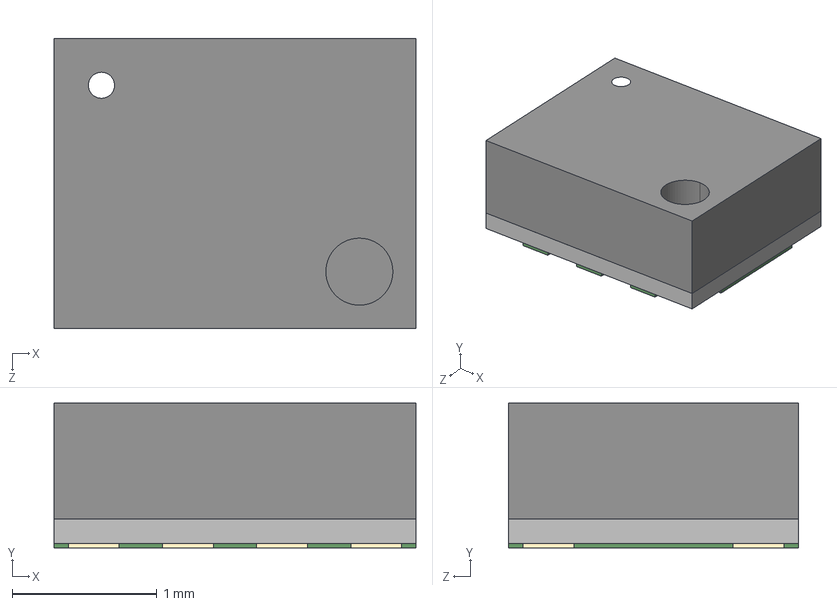
[picture p66: CAD file, 2022-12-28]
3d/DPS310.step
2.50 x 1.00 x 2.00 mm
