icl-rocketry/iclr-hw/3d/SRP5050FA-5R6M.stp

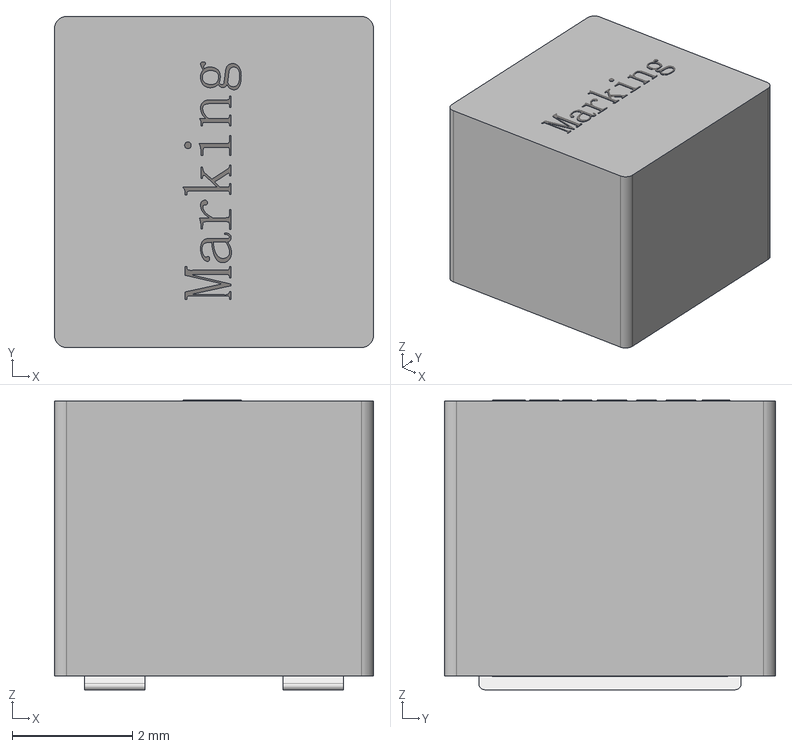
[picture p67: CAD file, 2022-12-22]
3d/SRP5050FA-5R6M.stp
5.30 x 5.50 x 4.81 mm
