icl-rocketry/iclr-hw/3d/LM2679T-3.3.step

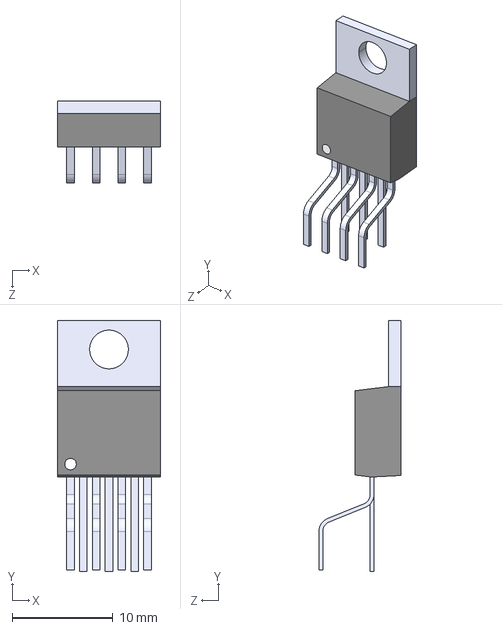
[picture p68: CAD file, 2022-06-18]
3d/LM2679T-3.3.step
10.2 x 24.9 x 8.14 mm
