icl-rocketry/iclr-hw/3d/c-292227-7-a1-3d.stp

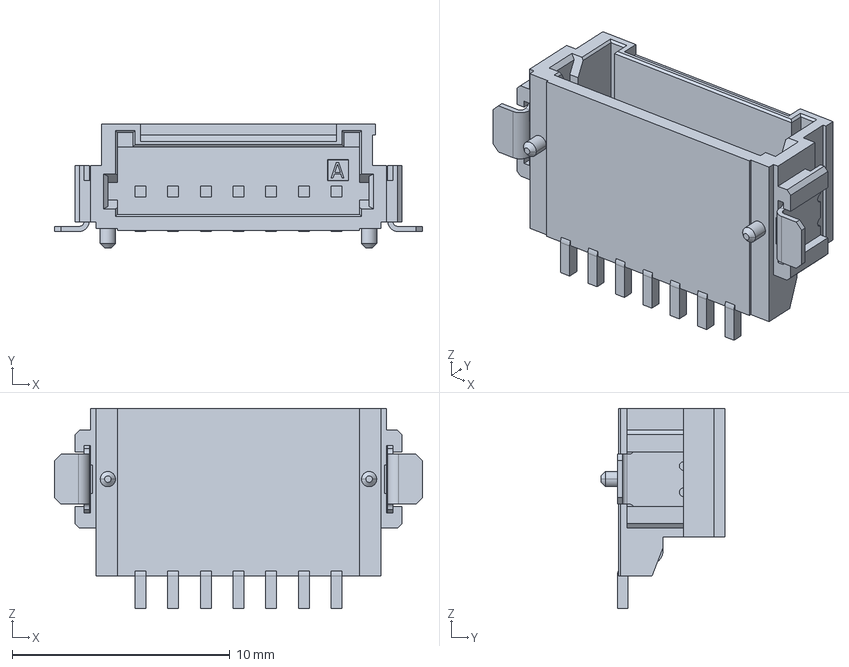
[picture p69: CAD file, 2022-03-28]
3d/c-292227-7-a1-3d.stp
16.9 x 5.70 x 9.20 mm
