icl-rocketry/iclr-hw/3d/SRP6540-390M.step

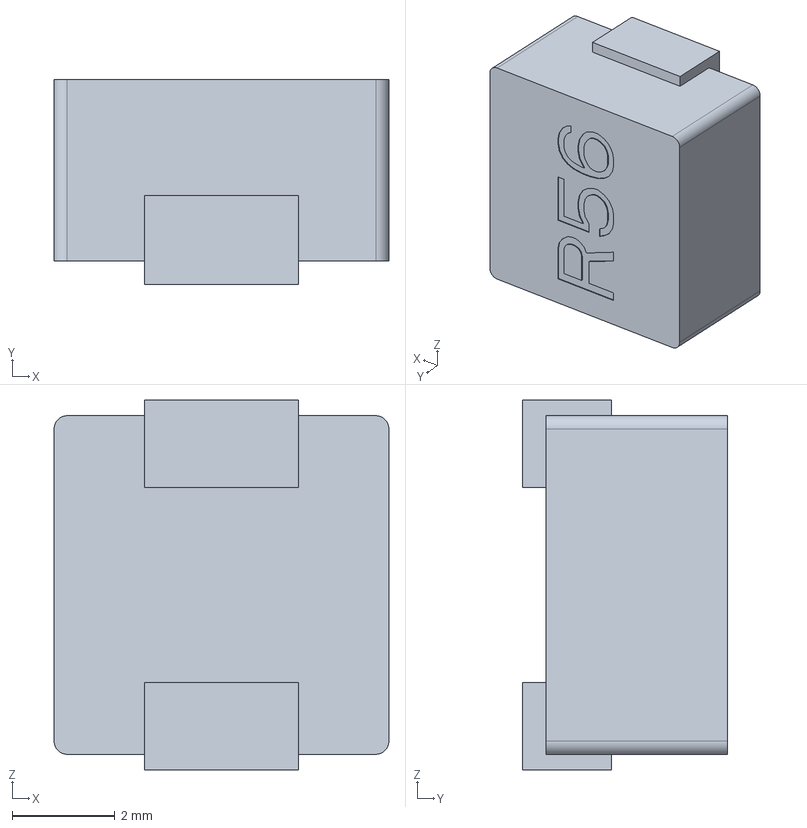
[picture p70: CAD file, 2022-03-01]
3d/SRP6540-390M.step
6.50 x 3.99 x 7.19 mm
