icl-rocketry/iclr-hw/3d/SOIC127P600X170-9N.step

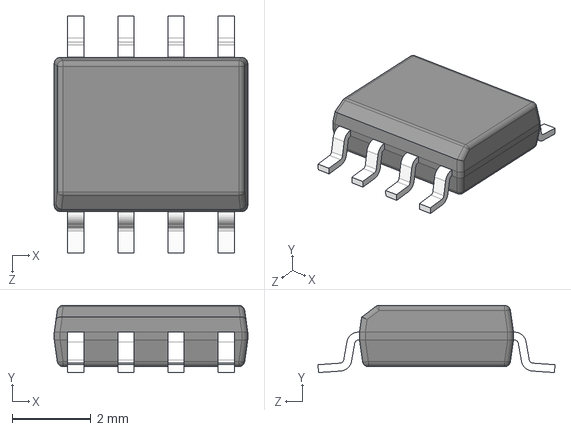
[picture p71: CAD file, 2022-02-14]
3d/SOIC127P600X170-9N.step
4.90 x 1.70 x 6.00 mm
