icl-rocketry/iclr-hw/3d/PCA9534RGVR.step

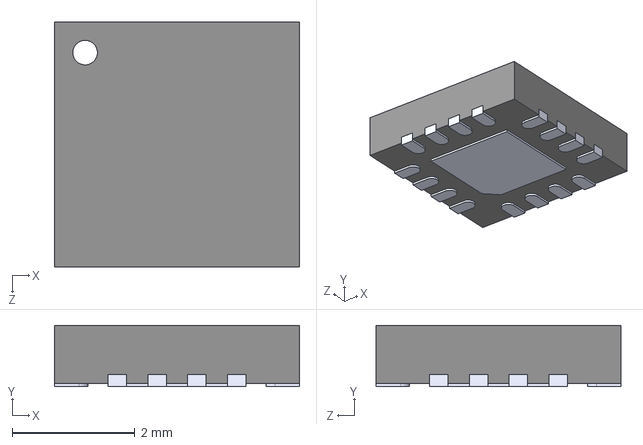
[picture p72: CAD file, 2022-02-11]
3d/PCA9534RGVR.step
4.00 x 1.00 x 4.00 mm
