icl-rocketry/iclr-hw/3d/ICM-20608-G.step

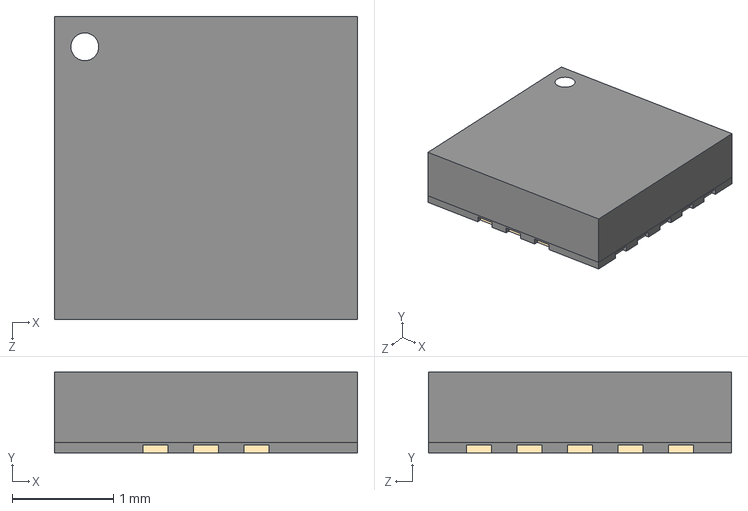
[picture p73: CAD file, 2022-02-10]
3d/ICM-20608-G.step
3.00 x 0.8 x 3.00 mm
