icl-rocketry/iclr-hw/3d/V3PAN50-M3_I.step

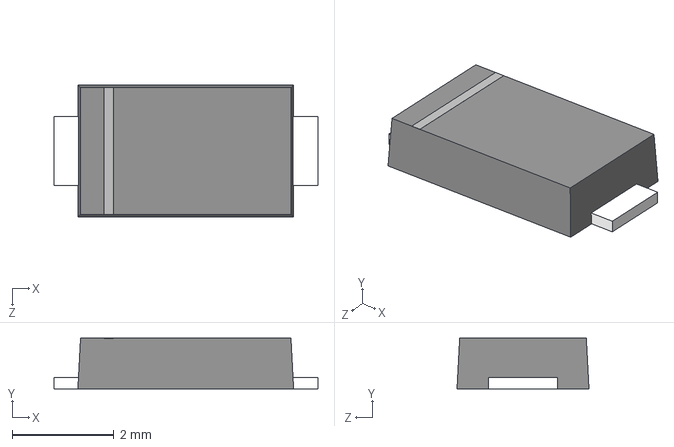
[picture p74: CAD file, 2022-02-10]
3d/V3PAN50-M3_I.step
5.20 x 1.00 x 2.60 mm
