icl-rocketry/iclr-hw/3d/ICM-20689.step

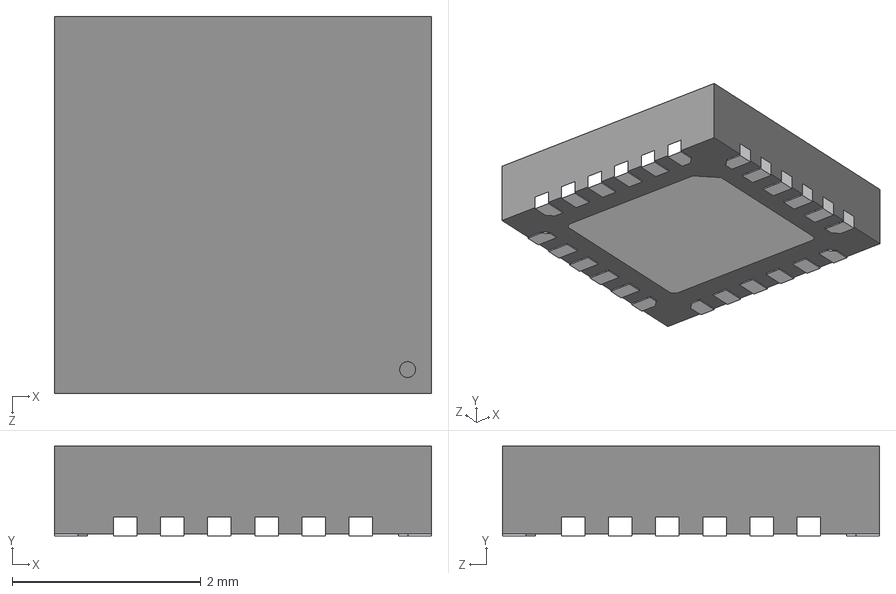
[picture p75: CAD file, 2022-01-29]
3d/ICM-20689.step
4.00 x 0.95 x 4.00 mm
