icl-rocketry/iclr-hw/3d/ETQP5M330YFM.step

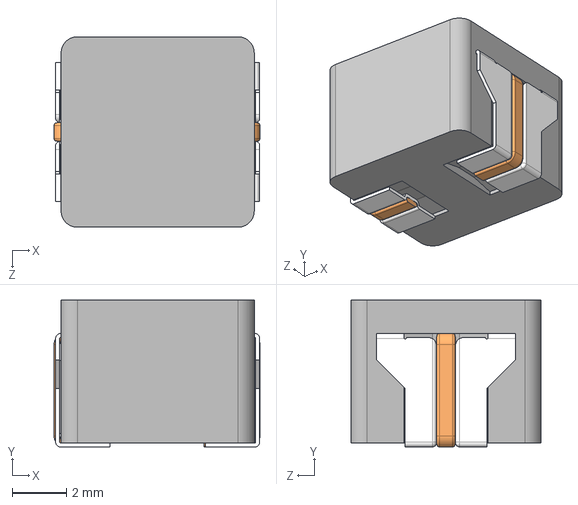
[picture p76: CAD file, 2022-01-29]
3d/ETQP5M330YFM.step
7.57 x 5.40 x 7.00 mm
