icl-rocketry/iclr-hw/3d/AMCA31-2R450G-S1F-T3.step

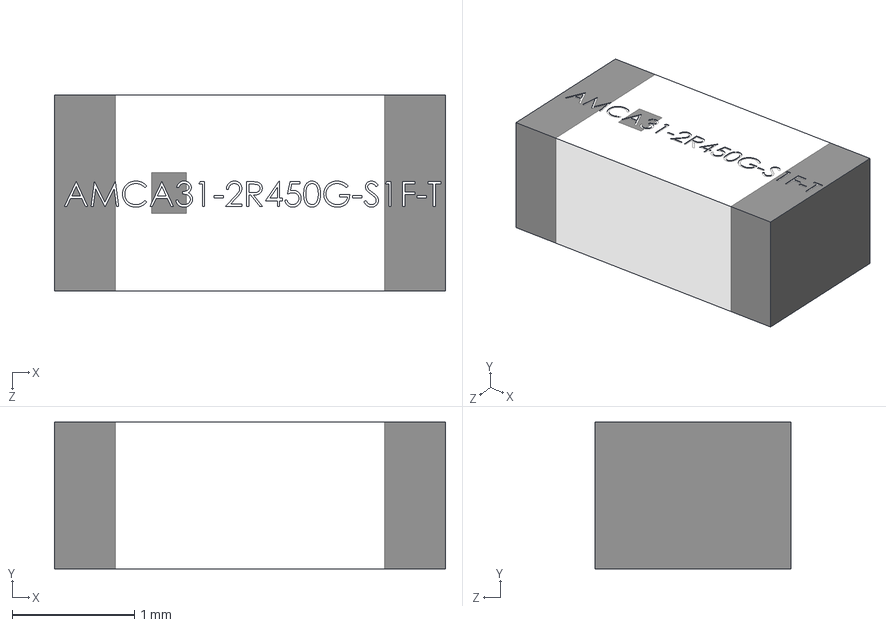
[picture p77: CAD file, 2021-11-27]
3d/AMCA31-2R450G-S1F-T3.step
3.20 x 1.20 x 1.60 mm
