icl-rocketry/iclr-hw/3d/SOIC127P599X175-8N.step

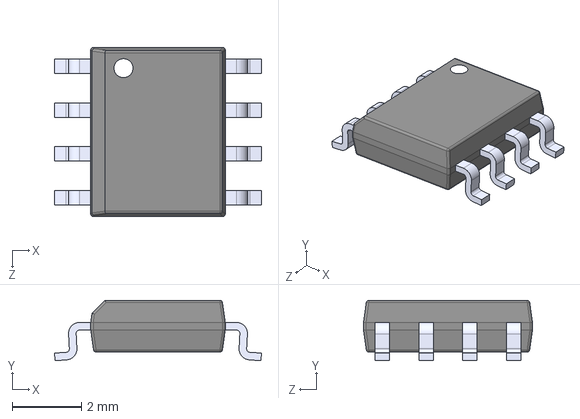
[picture p78: CAD file, 2021-11-13]
3d/SOIC127P599X175-8N.step
6.00 x 1.75 x 4.90 mm
