icl-rocketry/iclr-hw/3d/CP2102-GMR_QFN28_.step

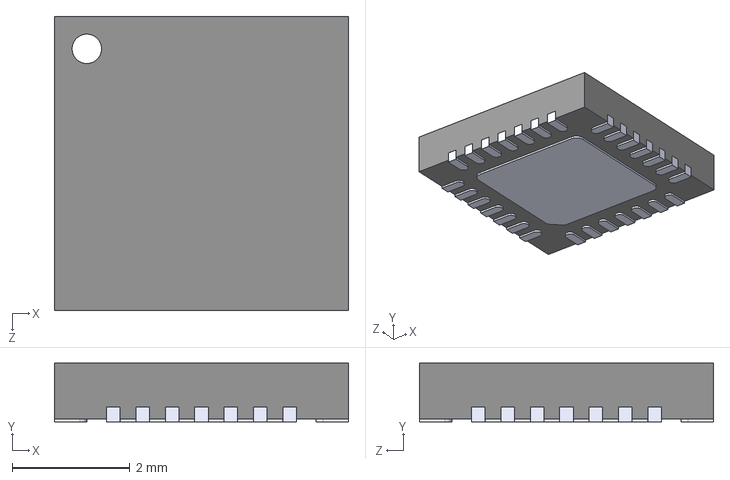
[picture p79: CAD file, 2021-11-13]
3d/CP2102-GMR_QFN28_.step
5.00 x 1.00 x 5.00 mm
