icl-rocketry/iclr-hw/3d/MTP3055VL.step

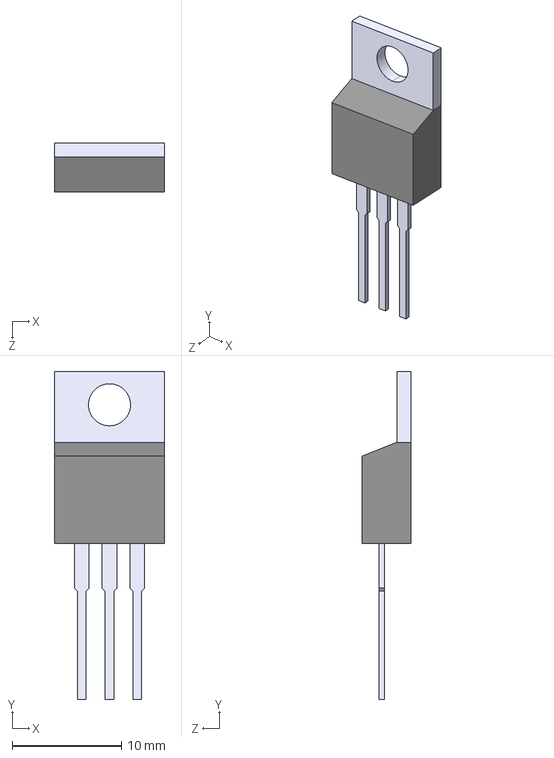
[picture p80: CAD file, 2021-05-22]
3d/MTP3055VL.step
10.1 x 30.0 x 4.44 mm
