icl-rocketry/iclr-hw/3d/21-0043D_8_MXM.step

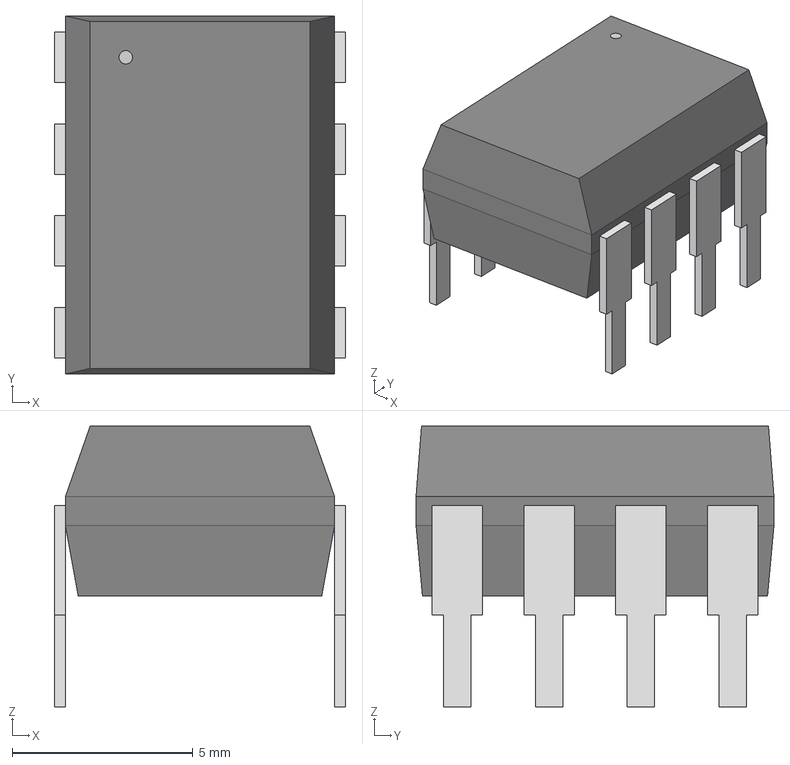
[picture p81: CAD file, 2021-05-22]
3d/21-0043D_8_MXM.step
8.06 x 9.91 x 7.78 mm
