icl-rocketry/iclr-hw/(list of files, cad)

Other CAD files:
3d/1053131102.stp
3d/12401598E4_2A.step
3d/26013144.stp
3d/732511150.stp
3d/9775026360 (rev1).stp
3d/LM66200DRLR.stp
3d/LM74810QDRRRQ1.stp
3d/MAX14871EUE_.step
3d/MAX25206ATPC_VY+.stp
3d/MAX77827AEFD+T.stp
3d/MP28167GQ-A-Z.stp
3d/TPS259830ONRGER.stp
3d/TPS61089RNRR.stp
3d/TPS61092RSAR.step
