icl-rocketry/iclr-hw/(commit log)

2019-11-02 Fixed refdes and added pad pin
2019-11-26 Screw switch
    [9775026360 (rev1).stp]
2019-11-26 Added PowerVFQN (TPS63070)
2019-11-29 Added 2.5mm VSON-10
2019-11-29 added xbee footprint
2020-01-20 added logo footprints
2020-01-20 Added radio connector 3d file
    [732511150.stp]
2021-05-22 Palash added stuff for CanSat
    Pls dont break
    [21-0043D_8_MXM.step]
2021-05-22 Added N-Channel MOSFET
    MTP3055VL
    [MTP3055VL.step]
2021-06-05 added 12401598E4#2A
    [12401598E4_2A.step]
2021-11-09 Cleaned up footprints and libraries
    Merged into one file
    [21-0043D_8_MXM.step]
2021-11-13 added cp2102 symbol and footprint
    [INTERFACE-CP2102-GMR_QFN28_.step]
2021-11-13 Added MAX14871, TPS54233D symbols and footprints
    [MAX14871EUE_.step, SOIC127P599X175-8N.step]
2021-11-27 added AMCA31-2R450G-S1F-T3 symbol and footprint
    [AMCA31-2R450G-S1F-T3.step]
2021-11-27 Added IRF620 mosfet symbol and footprint
    [IRF620PBF.STEP]
2021-12-04 Swapped IRF620 symbol and footprint with SIJA74DP
    [IRF620PBF.STEP]
2021-12-07 Removed unused mosfet footprint and symbols
    we were going to use these but now we're not so they can be deleted
2022-01-29 Converted symbol library to kicad 6
    Also added footprint for an inductor and footprint and symbol for H bridge BD62120AEFJ-E2
    [ETQP5M330YFM.step]
2022-01-29 added icm-20689
    [ICM-20689.step]
2022-02-01 Added symbol and footprint for V8PAM10S schottky diode
    [V3PAN50-M3_I.step]
2022-02-10 added 2 imus and a mag
    [ICM-20608-G.step]
2022-02-11 added more components
    [PCA9534RGVR.step]
2022-02-14 Added LMR14050-Q1 buck converter
    [SOIC127P600X170-9N.step]
2022-02-14 slight changes to V8PAM schottky diode
2022-02-19 tidy up library
    power board components
2022-03-01 added footprint for pickle's buck converter inductor
    [SRP6540-390M.step]
2022-03-25 added tps61092
    [TPS61092RSAR.step]
2022-03-28 Added Chad footprint
2022-03-31 Added symbols for CAN repeater + 1 of the footprints
    [SN74LVC2G132DCUR.step]
2022-04-02 Added footprints and 3d models for arbitration ICs
    [SN74LVC2G07DBVR.step, SN74LVC2G08DCUR.step]
2022-04-12 Corrected footprint for RT9025
2022-04-14 Added LQG15WZ1N8B02D fp
    fixed inductor fp for the sensor board
2022-04-15 additional component for CAN board
    [SN74LVC2G04DBVR.step]
2022-04-15 added spider men pointing at each other footprint
2022-06-18 added LM2579T footprint and symbol
    [LM2679T-3.3.step]
2022-06-18 added FP for PDU charge chip inductor
2022-07-18 added fp for 74438336068
    sensor board inductor
2022-07-27 added silkscreen for KERMIT and toptrumps logo
2022-11-15 added 3.3V buck boost symbol
2022-11-16 added new LDO symbol and footprint
2022-11-19 added sic437, ssm6j511, sot65p210x110-6n
    [SN74LVC1G373DCKR.step]
2022-11-19 Revert "added sic437, ssm6j511, sot65p210x110-6n"
    This reverts commit 9618e11e89c2294dc1c2dbfccbd162fde1370a47.
    [SN74LVC1G373DCKR.step]
2022-11-19 added 1053131104
    fp and symbol added. 4 pin nanofit header
2022-12-10 added LM2623-Q1
    10v rail for kermitv2
2022-12-22 added chad inductor fp and 3d model
    [SRP5050FA-5R6M.stp]
2022-12-28 added dps310
    [DPS310.step]
2023-01-28 added cursed mini solder jumper
2023-02-04 added smd usb port fp and symbol
    [USB4110-GF-A_REVB.step]
2023-02-10 added 3 pin horizontal nanofit (for chad)
    [3pinnanofithorizontal.stp]
2023-02-10 actually this time... last one was SMD
    [3pinnanofithorizontal.stp]
2023-02-10 added RBUS connector 3d model
    [RBUS.stp]
2023-02-25 updated iclr logo
    [USB_C_Receptacle_Palconn_UTC16-G.step]
2023-02-25 added cads for angled nanofits, angled xt60, angles 8pin minifit
    [1053131102.stp, 26013144.stp, XT60PW FEMALE.STEP, XT60PW MALE.STEP]
2023-02-27 added new chad inductor
    [EXL1V0705-3R3-R.stp]
2023-03-08 Added 6 pin mini fit jr with no mounting holes
2023-03-08 witcher switcher logo
2023-03-14 added my homebrew inductor footprint
2023-05-26 added n channel mosfet BUK9M11-40HX
2023-05-27 p160 potentiometer, SER2011-202ML inductor
2023-06-03 Added Components
    [AP2205-W5-7.stp, ESP32-S3--3DModel-STEP-510211.STEP, ETQP4M4R7KVC.STEP, H3LIS331DLTR.stp, MAX-M8Q--3DModel-STEP-56544.STEP, MMC5983MA--3DModel-STEP-269445.STEP, MP28167GQ-A-Z.stp, MPL-AL6050-4R7.STEP]
2023-06-06 added 1 component
    [LM66200DRLR.stp]
2023-06-16 funky silkscreens
2023-06-24 XFL2010-183MEC kermitv2 inductor
    for 10V boost
2023-07-03 Added 3Dmodels for Cheese
    [HEF4051BT,653.STEP, MAX77827AEFD+T.stp]
2023-07-08 kermit boost converter footprint
2023-07-13 Added a load of 3d stuff for kermit
    [2pinTerminal2.54.stp, 2pinTerminal3.5.STEP, 4pinnanofithorizontal.stp, ADS131M06IRSNR.stp, SRR6038-5R0Y.stp, WLPMA0A040M2R2LC.stp]
2023-08-23 Pete silkscreen
2023-09-02 sqs141 p channel mosfets
2023-11-11 Added AD7150 KiCad Files
2024-01-30 Added MIC2253
    [MIC2253-06YML.stp]
2024-03-06 Added specific components for Kangaroo
    Added SBR1045 5A 3Pin Diode, Barrier Diode, 50uH Inductor with symbols, footprints and 3D models
    [B540C-13-F.step, P0848NL.stp, SBR1045CTL-13.step]
2024-05-19 Fixed the 10mm iclr logo,added scaled down logos
2024-06-09 Added a bunch of 3d steps
    [23Buckaroo v4.step, ADS131M04IRUKR.stp, BUK9M11-40HX.stp, MAX25206ATPC_VY+.stp, MPRLS0025PA00001A.stp, NX2016SA.STEP, SER2011.STEP, SN74LVC2G08DCUR.step]
2024-07-11 Some 3D model assignments
    [DPS368XTSA1.stp]
2024-07-11 Better RAE logos, fixed buck boost footprint
2024-07-31 XT30 with 3d model and symbol, COTS charger and buck
    [XT30PW-F.stp, XT30PW-M.stp]
2024-07-31 charger footprint update
2024-08-04 added s-102t
    [S-102T.stp]
2024-08-05 witcher mosfet symbol change
2024-08-07 added sometning;
    [CMT-0525-75-SMT-TR.stp]
2024-08-09 New sd card port + started the readme
    [ST1W008S4TR2000.step]
2024-08-14 some 3d models
    [SPM10065VT-3R3M-D.step]
2024-08-14 last of chad 3d models
    [SOT-723.step]
2024-08-18 Fixed the 2x TVS symbol, added 3d for the 6x TVS
    [RCLAMP3346PTNT.stp]
2024-08-22 added based n fet
    [BSZ025N04LS.stp]
2024-08-24 andu fix this;
    [MIC5060YML-TR.stp]
2024-08-27 tmc2209 added
    [TMC2209-LA.stp]
2024-09-02 added lm74810 ideal diode
    [LM74810QDRRRQ1.stp]
2024-09-05 solder jumper edit and solenoid schottky diode
    [V8PAM10S-M3_I.stp]
2024-09-10 added new symbols for dom
    [ERJ-HP6F7322V.stp, FDSD0630-H-1R0M_P3.step, VCAS080512A250DP.stp]
2024-09-12 Added stuff
    [2pinnanofithorizontal.STEP, SI7635DP-T1-GE3.STEP, TPS259830ONRGER.stp]
2025-02-13 silkscreen cleanup on MP28167 bb chip
2025-02-14 More pickle 3d models
    [Pico-Clasp_SMD_7p.step]
2025-03-29 Small 3pin solder jumper
2025-05-08 Added some stark 3d models
    [Pico-Clasp_SMD_4p.stp, TCMT1109.STEP, WE-XHMI.stp]
2025-06-28 Modified MAX77827 buck boost dot marker to clear template resistor positioning
2025-12-16 old nand files + tvs diode and lib for it
    [SON127P600X800X65-8N.STEP]
